themathgeek13/custom-pic-quad/Quad-V3/Eagle/PDF/ControlBoardV3-4L.Brd.pdf

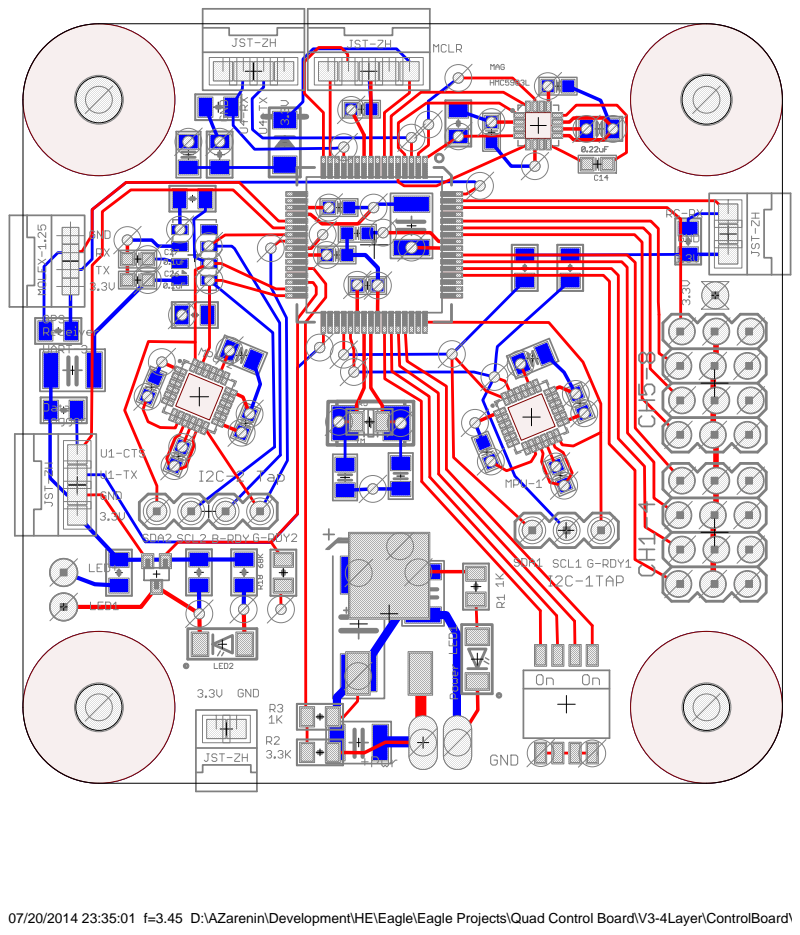
[picture p1: page 1]

07/20/2014 23:35:01 f=3.45 D:\AZarenin\Development\HE\Eagle\Eagle Projects\Quad Control Board\V3-4Layer\ControlBoardV
