themathgeek13/custom-pic-quad/Quad-V3/Eagle/PDF/ControlBoardV3-4L.Description.pdf

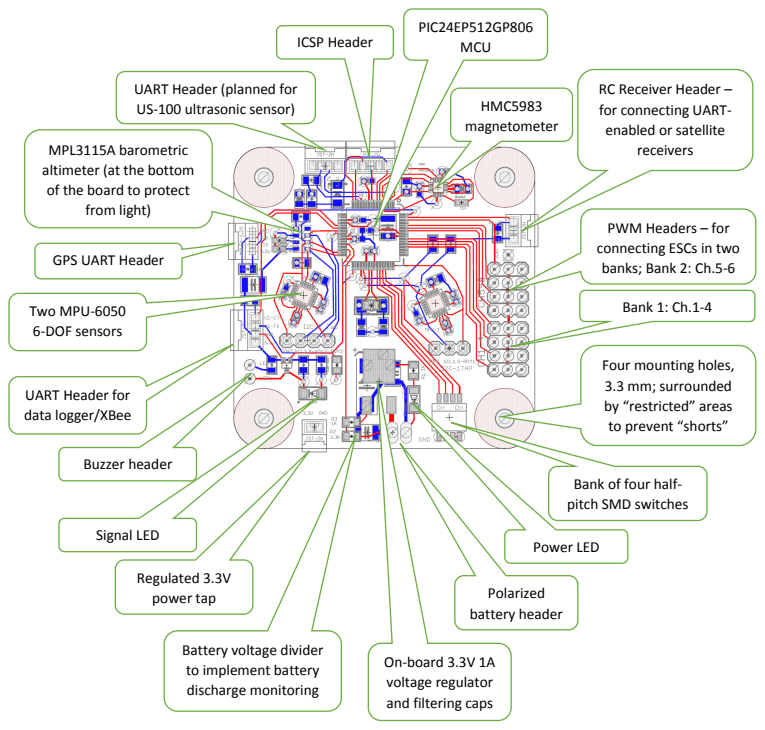
[picture p2: page 1]
ICSP Header; Bank 1: Ch.1-4; Polarized battery header; HMC5983 magnetometer; PIC24EP512GP806 MCU; Buzzer header; Signal LED; Power LED; Regulated 3.3V power tap; Two MPU-6050 6-DOF sensors

UART Header (planned for
US-100 ultrasonic sensor)

RC Receiver Header –
for connecting UART-
enabled or satellite
receivers

MPL3115A barometric
altimeter (at the bottom
of the board to protect
from light)

PWM Headers – for
connecting ESCs in two
banks; Bank 2: Ch.5-6

GPS UART Header

Four mounting holes,
3.3 mm; surrounded
by “restricted” areas
to prevent “shorts”

UART Header for
data logger/XBee

Bank of four half-
pitch SMD switches

Battery voltage divider
to implement battery
discharge monitoring

On-board 3.3V 1A
voltage regulator
and filtering caps
