themathgeek13/custom-pic-quad/Quad-V3/Eagle/PDF/ControlBoardV3-4L.Sch.pdf

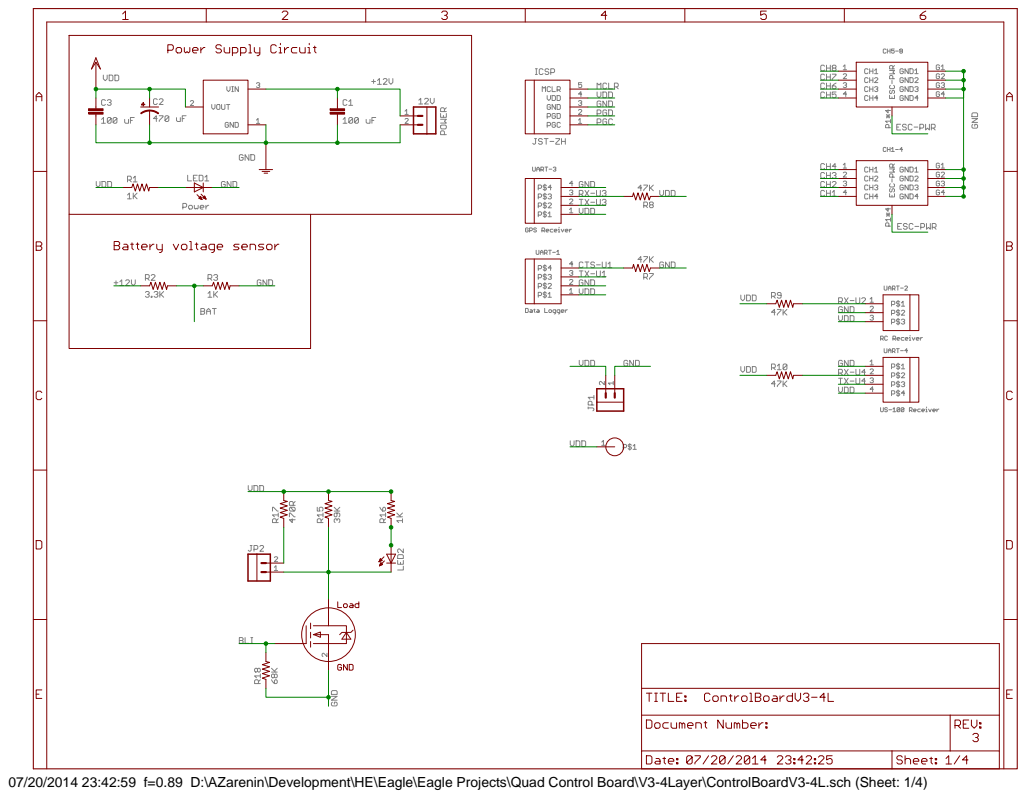
[picture p3: page 1]

07/20/2014 23:42:59 f=0.89 D:\AZarenin\Development\HE\Eagle\Eagle Projects\Quad Control Board\V3-4Layer\ControlBoardV3-4L.sch (Sheet: 1/4)

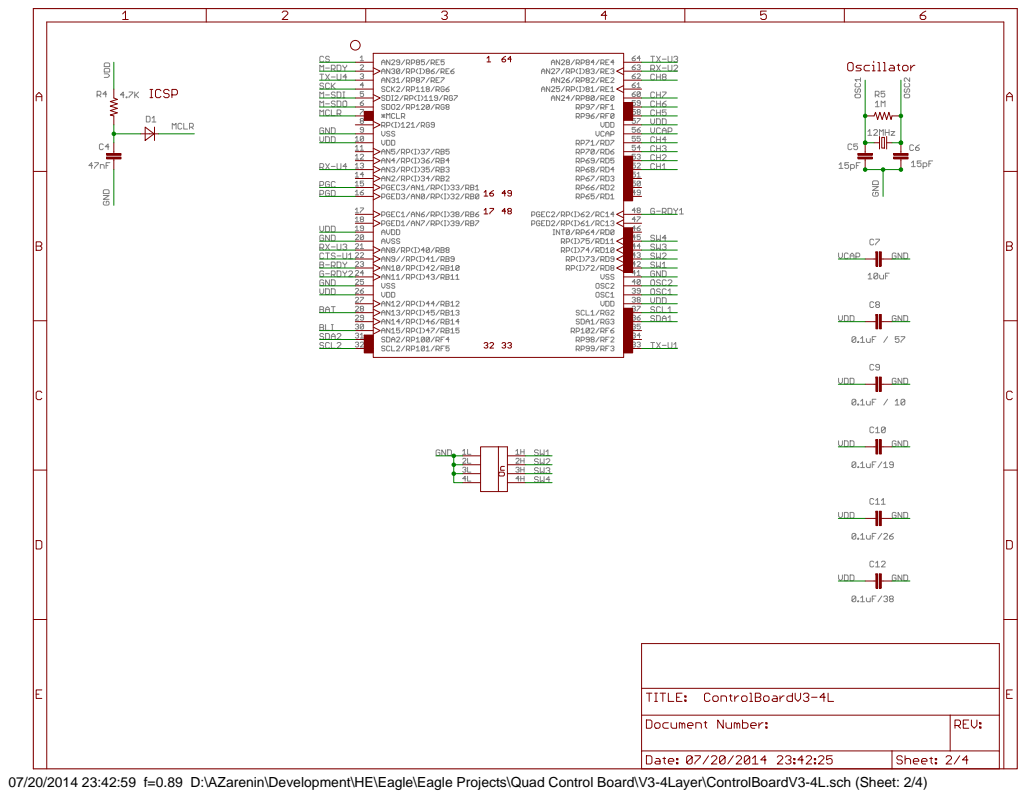
[picture p4: page 2]

07/20/2014 23:42:59 f=0.89 D:\AZarenin\Development\HE\Eagle\Eagle Projects\Quad Control Board\V3-4Layer\ControlBoardV3-4L.sch (Sheet: 2/4)

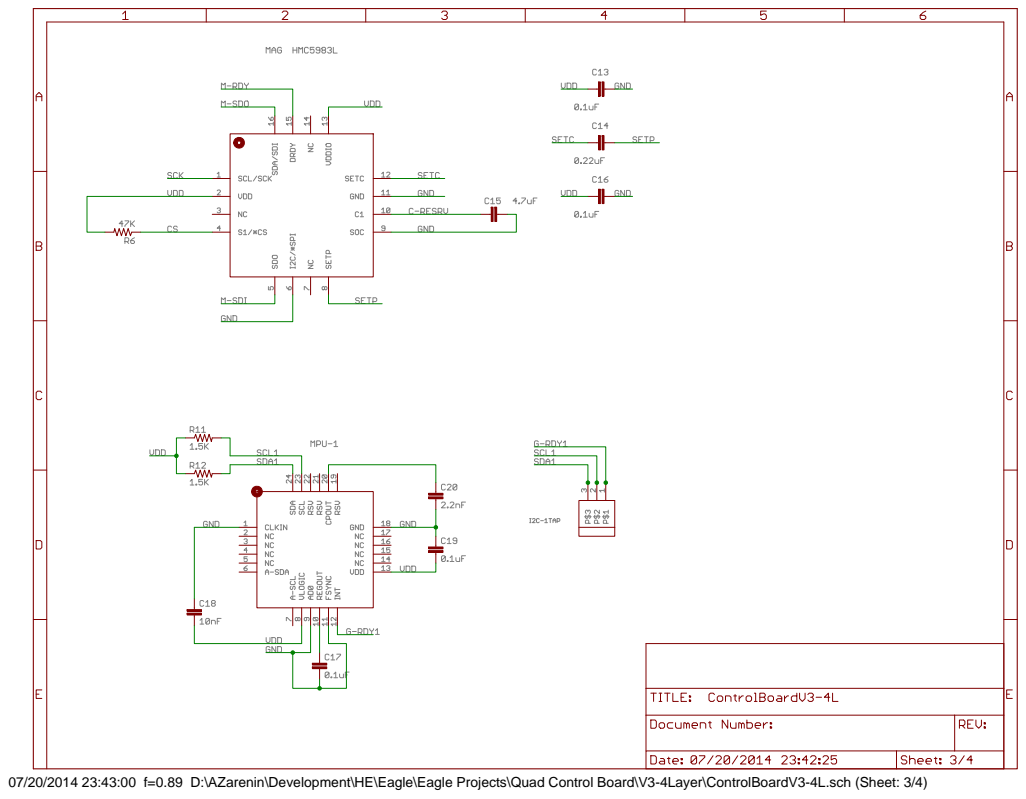
[picture p5: page 3]

07/20/2014 23:43:00 f=0.89 D:\AZarenin\Development\HE\Eagle\Eagle Projects\Quad Control Board\V3-4Layer\ControlBoardV3-4L.sch (Sheet: 3/4)

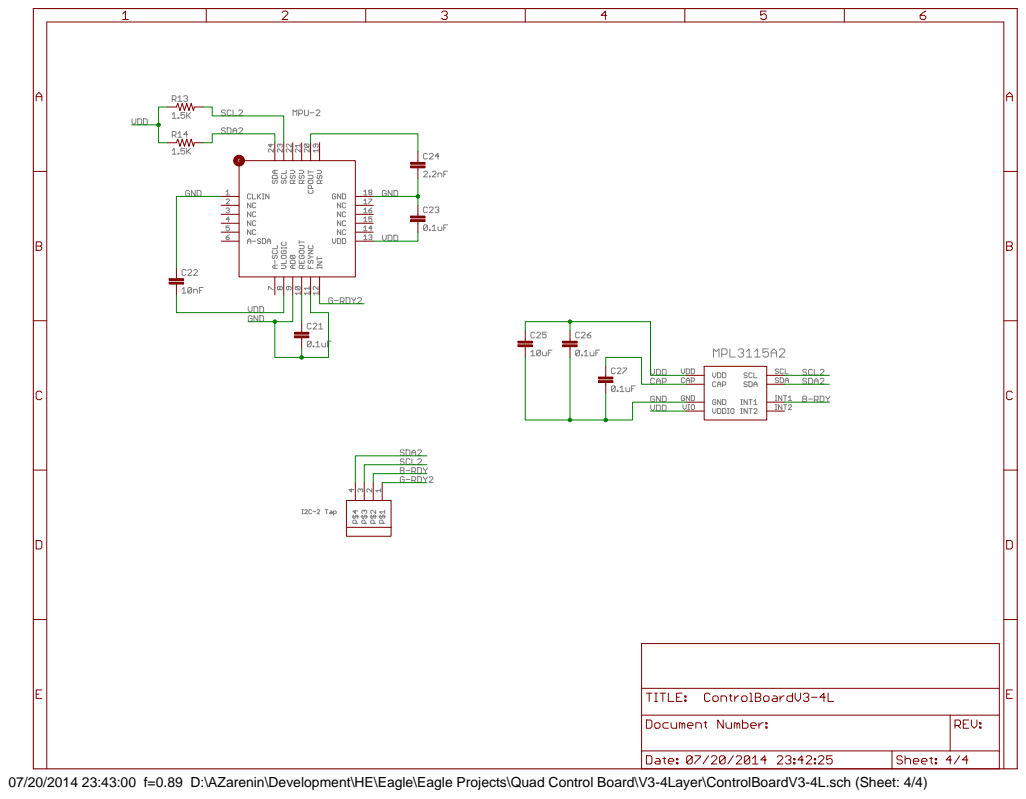
[picture p6: page 4]

07/20/2014 23:43:00 f=0.89 D:\AZarenin\Development\HE\Eagle\Eagle Projects\Quad Control Board\V3-4Layer\ControlBoardV3-4L.sch (Sheet: 4/4)
