themathgeek13/custom-pic-quad/SD-Logger/SD-Logger-V2/Eagle/DataLoggerV2.sch.pdf

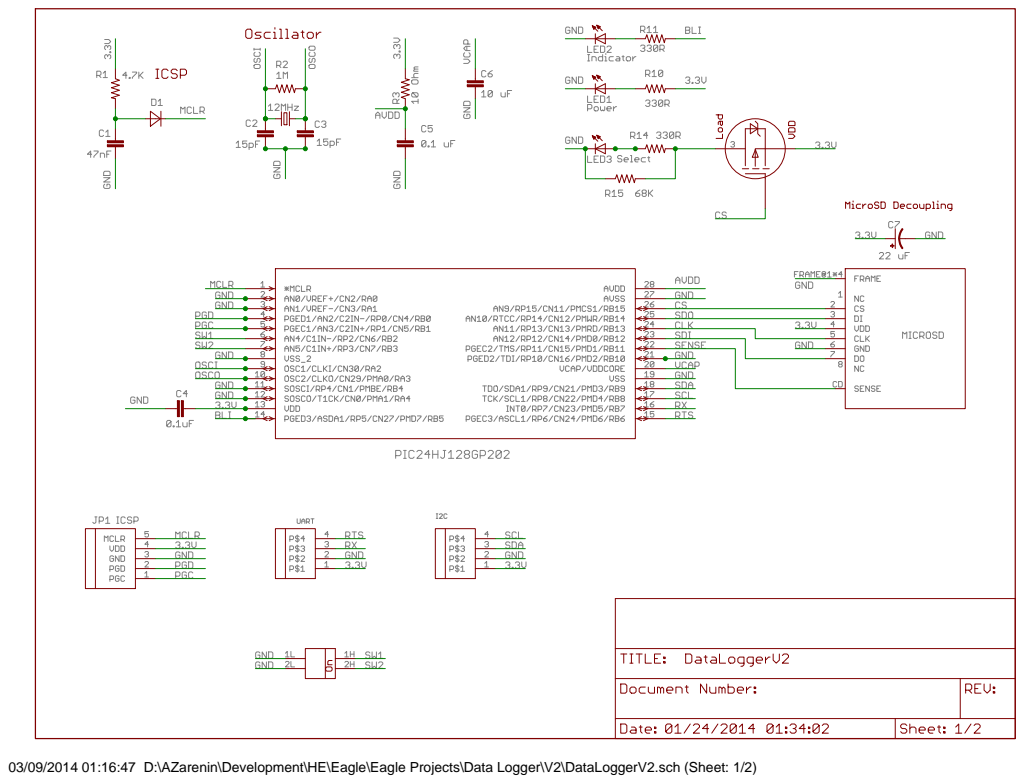
[picture p7: page 1]

03/09/2014 01:16:47 D:\AZarenin\Development\HE\Eagle\Eagle Projects\Data Logger\V2\DataLoggerV2.sch (Sheet: 1/2)
