themathgeek13/custom-pic-quad/Quad-V2/Eagle/Control Board Schematic.pdf

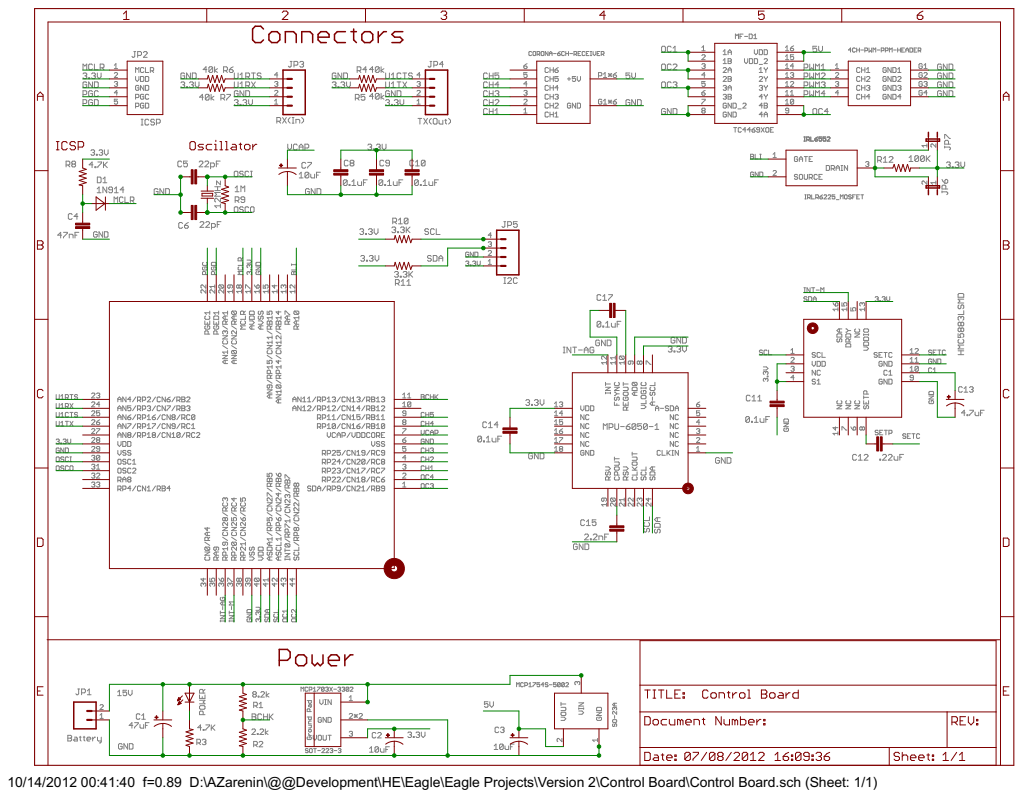
[picture p8: page 1]

10/14/2012 00:41:40 f=0.89 D:\AZarenin\@@Development\HE\Eagle\Eagle Projects\Version 2\Control Board\Control Board.sch (Sheet: 1/1)
