themathgeek13/custom-pic-quad/Quad-V2/Eagle/Control Board.pdf

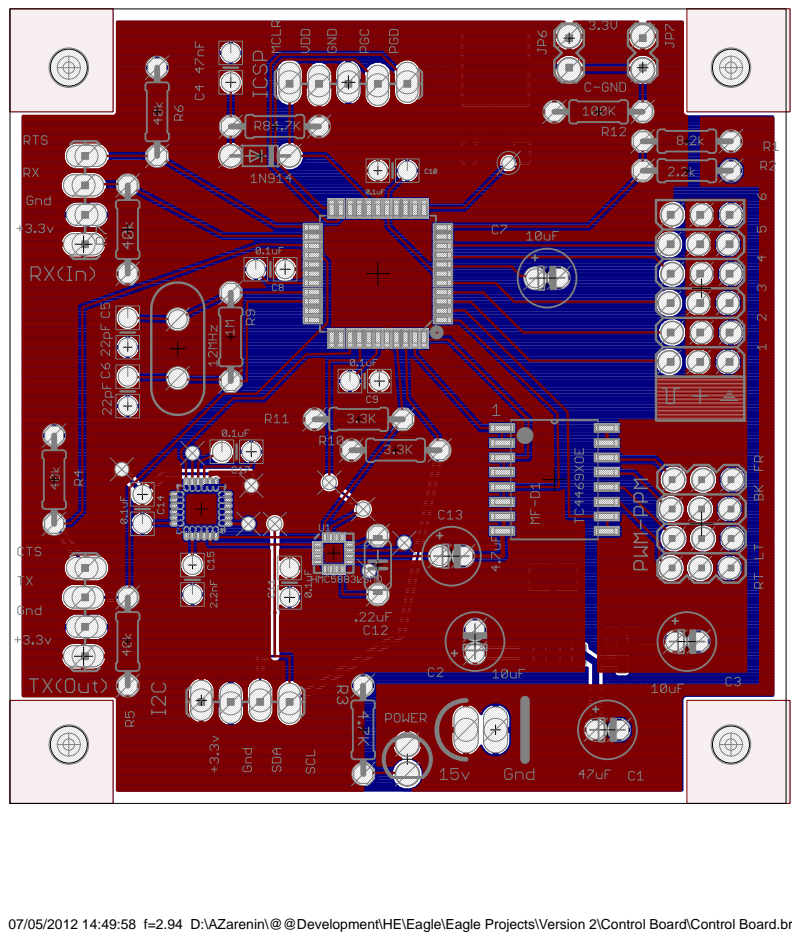
[picture p9: page 1]

07/05/2012 14:49:58 f=2.94 D:\AZarenin\@@Development\HE\Eagle\Eagle Projects\Version 2\Control Board\Control Board.br
