themathgeek13/custom-pic-quad/Quad-V3/Eagle/ControlBoardV3-4L.brd

## EAGLE design Quad-V3/Eagle/ControlBoardV3-4L.brd (2014-07-21)

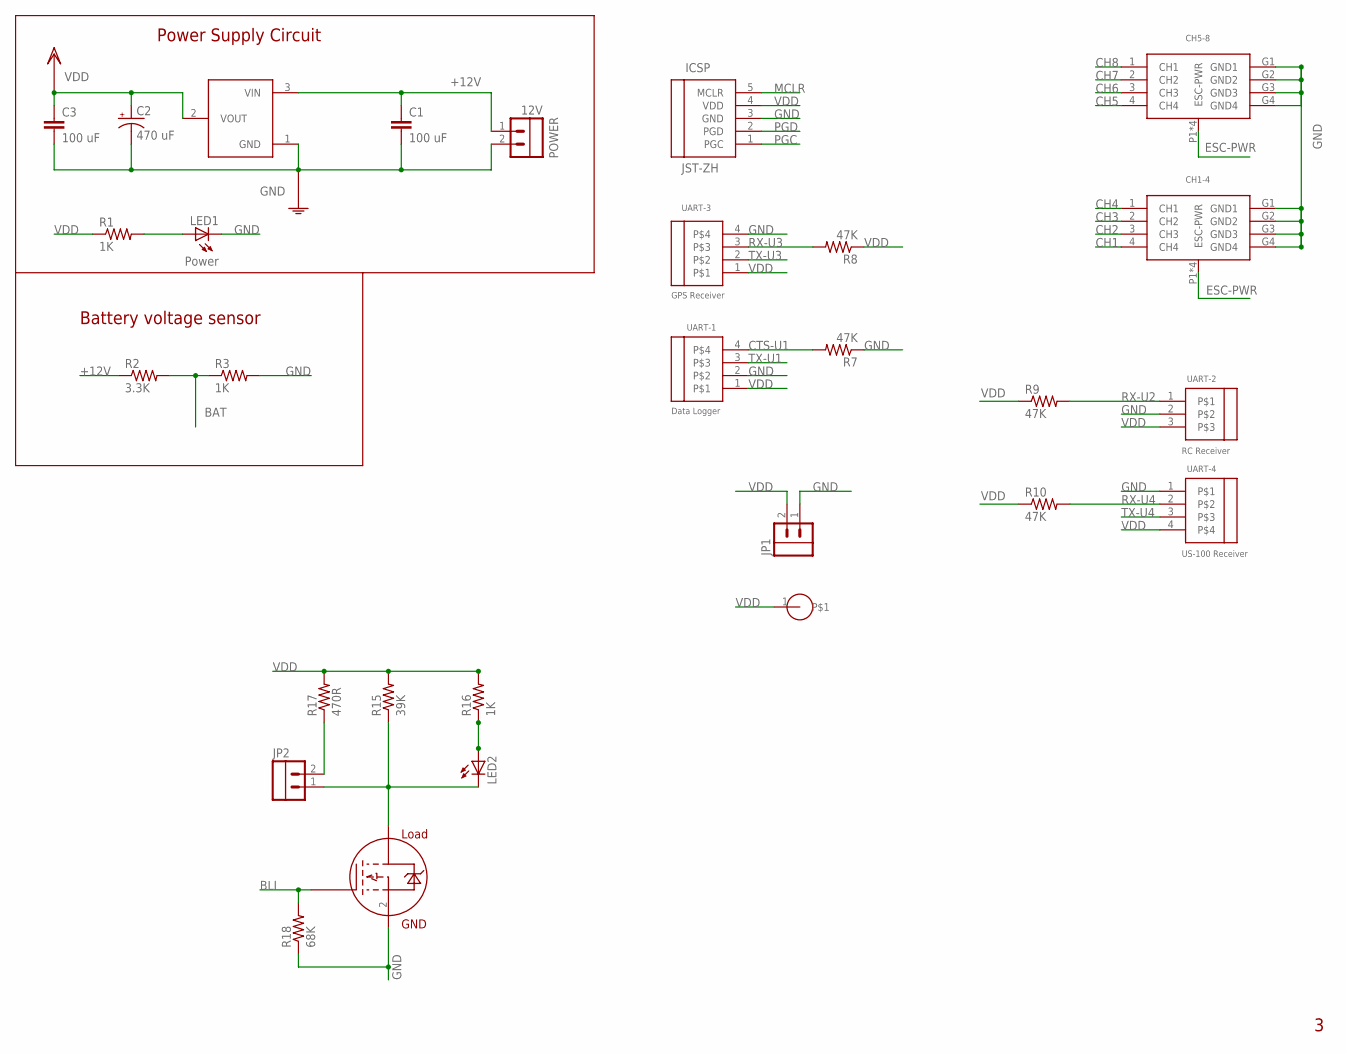
[picture p10: schematic ControlBoardV3-4L.sch, sheet 1]

Parts:
C1, C3: 100 uF; 1210_INCH-HS-CAP
C2: 470 uF; TANT-D-7343
CH1-4, CH5-8: 4CH-PWM-PPM-HEADER; 4CH-PWM-PPM-HEADER-PACKAGE
ICSP: JST-ZH; 1X05-JST-ZH
JP1: HEADER-02_JST_ZH; 1X02-JST-ZH
JP2: HEADER-02_0.1"_NO_SILK; 1X02_100MIL_NO_SILK
LED1: Power; 1206_INCH-HS-LED
LED2: LED_SMD_1206; 1206_INCH-HS-LED
POWER: 12V; 1X02_100MIL_LONGPADS
R1, R3, R16: 1K; 0805_INCH-HS
R2: 3.3K; 0805_INCH-HS
R7, R8, R9, R10: 47K; 0805_INCH-HS
R15: 39K; 0805_INCH-HS
R17: 470R; 0805_INCH-HS
R18: 68K; 0805_INCH-HS
U$2: NCP1117_DPAK; DPAK-ONSEMI
U$5: N-MOSFET_SOT-323; SOT-323
U$6: TAP-01_PRECISE; 1X01_PRECISE
UART-1: Data Logger; 1X04-JST-ZH
UART-2: RC Receiver; 1X03-JST-ZH
UART-3: GPS Receiver; 1X04-MOLEX-PICOBLADE
UART-4: US-100 Receiver; 1X04-JST-ZH

Connections:
+12V: C1.P$1 (1), POWER.1, R2.1, U$2.3 (VIN)
BAT: R2.2, R3.1; also elsewhere on the board
BLI: R18.2, U$5.1 (G); also elsewhere on the board
CH1: CH1-4.4 (CH4); also elsewhere on the board
CH2: CH1-4.3 (CH3); also elsewhere on the board
CH3: CH1-4.2 (CH2); also elsewhere on the board
CH4: CH1-4.1 (CH1); also elsewhere on the board
CH5: CH5-8.4 (CH4); also elsewhere on the board
CH6: CH5-8.3 (CH3); also elsewhere on the board
CH7: CH5-8.2 (CH2); also elsewhere on the board
CH8: CH5-8.1 (CH1); also elsewhere on the board
CTS-U1: R7.2, UART-1.4; also elsewhere on the board
ESC-PWR: CH1-4.P1 (ESC-PWR), CH1-4.P2 (ESC-PWR), CH1-4.P3 (ESC-PWR), CH1-4.P4 (ESC-PWR), CH5-8.P1 (ESC-PWR), CH5-8.P2 (ESC-PWR), CH5-8.P3 (ESC-PWR), CH5-8.P4 (ESC-PWR)
GND: C1.P$2 (2), C2.-, C3.P$2 (2), CH1-4.G1 (GND1), CH1-4.G2 (GND2), CH1-4.G3 (GND3), CH1-4.G4 (GND4), CH5-8.G1 (GND1), CH5-8.G2 (GND2), CH5-8.G3 (GND3), CH5-8.G4 (GND4), ICSP.3 (GND), JP1.1, LED1.C, POWER.2, R3.2, R7.1, R18.1, U$2.1 (GND), U$5.2 (S), UART-1.2, UART-2.2, UART-3.4, UART-4.1; also elsewhere on the board
MCLR: ICSP.5 (MCLR); also elsewhere on the board
unnamed: LED1.A, R1.2
unnamed: JP2.2, R17.1
unnamed: JP2.1, LED2.C, R15.1, U$5.3 (D)
unnamed: LED2.A, R16.1
PGC: ICSP.1 (PGC); also elsewhere on the board
PGD: ICSP.2 (PGD); also elsewhere on the board
RX-U2: R9.2, UART-2.1; also elsewhere on the board
RX-U3: R8.2, UART-3.3; also elsewhere on the board
RX-U4: R10.2, UART-4.2; also elsewhere on the board
TX-U1: UART-1.3; also elsewhere on the board
TX-U3: UART-3.2; also elsewhere on the board
TX-U4: UART-4.3; also elsewhere on the board
VDD: C2.+, C3.P$1 (1), ICSP.4 (VDD), JP1.2, R1.1, R8.1, R9.1, R10.1, R15.2, R16.2, R17.2, U$2.2 (VOUT), U$6.1, UART-1.1, UART-2.3, UART-3.1, UART-4.4; also elsewhere on the board

Notes on the sheet:
Power Supply Circuit
Battery voltage sensor

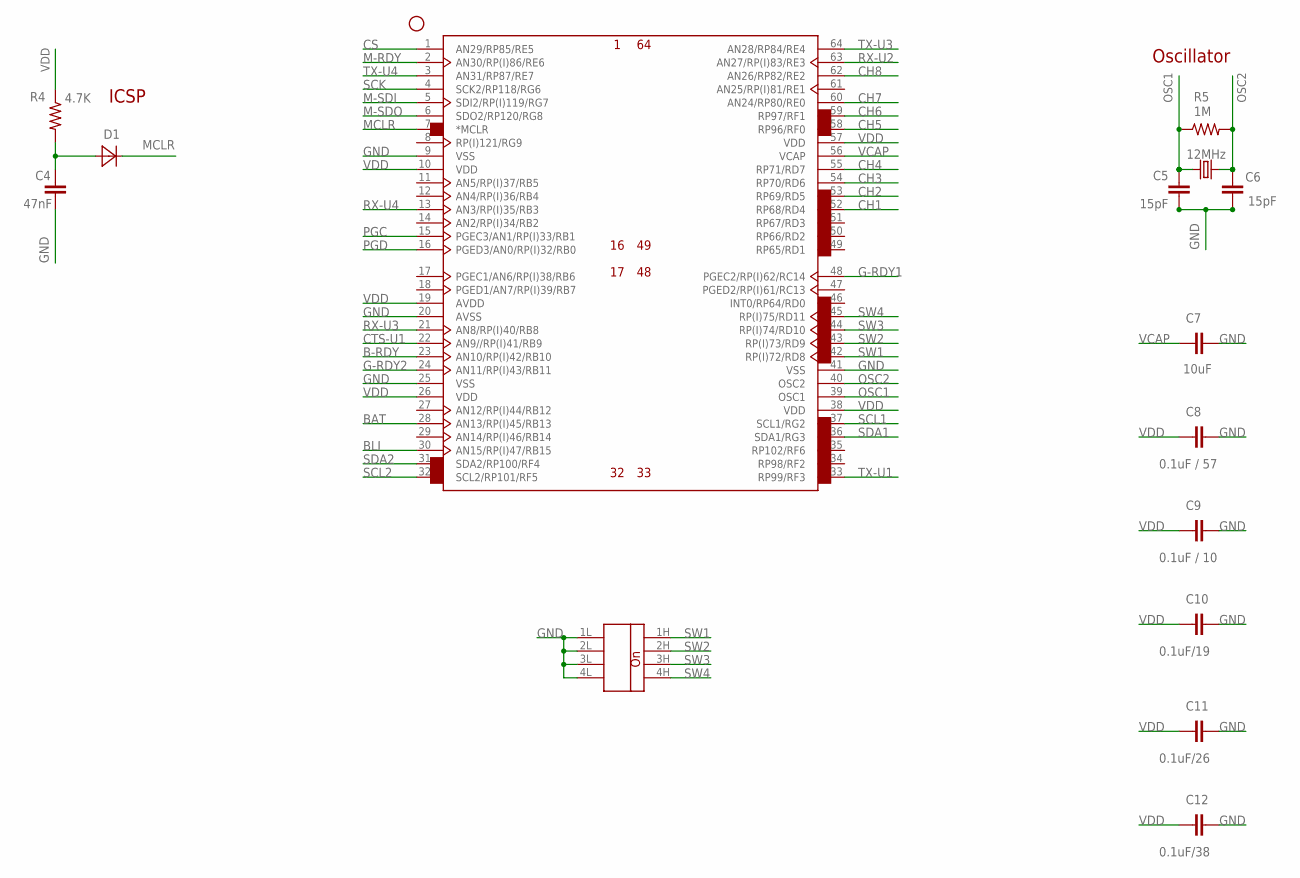
[picture p11: schematic ControlBoardV3-4L.sch, sheet 2]

Parts:
C4: 47nF; 0805_INCH-HS-CAP
C5, C6: 15pF; 0805_INCH-HS-CAP
C7: 10uF; 1210_INCH-HS-CAP
C8: 0.1uF / 57; 0603_INCH-HS-CAP
C9: 0.1uF / 10; 0603_INCH-HS-CAP
C10: 0.1uF/19; 0603_INCH-HS-CAP
C11: 0.1uF/26; 0603_INCH-HS-CAP
C12: 0.1uF/38; 0603_INCH-HS-CAP
D1: DIODE_1206; 1206_INCH-HS-DIODE
Q1: 12MHz; CRYSTAL-SMD-5.0X3.2
R4: 4.7K; 0805_INCH-HS
R5: 1M; 0805_INCH-HS
U$1: PIC24EP512GP806_TQFP64-10X10; TQFP64-10X10X1MM
U$3: SWITCH-4_HALF-PITCH; DIP-4-HP

Connections:
B-RDY: U$1.23 (AN10/RP(I)42/RB10); also elsewhere on the board
BAT: U$1.28 (AN13/RP(I)45/RB13); also elsewhere on the board
BLI: U$1.30 (AN15/RP(I)47/RB15); also elsewhere on the board
CH1: U$1.52 (RP68/RD4); also elsewhere on the board
CH2: U$1.53 (RP69/RD5); also elsewhere on the board
CH3: U$1.54 (RP70/RD6); also elsewhere on the board
CH4: U$1.55 (RP71/RD7); also elsewhere on the board
CH5: U$1.58 (RP96/RF0); also elsewhere on the board
CH6: U$1.59 (RP97/RF1); also elsewhere on the board
CH7: U$1.60 (AN24/RP80/RE0); also elsewhere on the board
CH8: U$1.62 (AN26/RP82/RE2); also elsewhere on the board
CS: U$1.1 (AN29/RP85/RE5); also elsewhere on the board
CTS-U1: U$1.22 (AN9//RP(I)41/RB9); also elsewhere on the board
G-RDY1: U$1.48 (PGEC2/RP(I)62/RC14); also elsewhere on the board
G-RDY2: U$1.24 (AN11/RP(I)43/RB11); also elsewhere on the board
GND: C4.2, C5.1, C6.1, C7.P$2 (2), C8.2, C9.2, C10.2, C11.2, C12.2, U$1.9 (VSS), U$1.20 (AVSS), U$1.25 (VSS), U$1.41 (VSS), U$3.1L, U$3.2L, U$3.3L, U$3.4L; also elsewhere on the board
M-RDY: U$1.2 (AN30/RP(I)86/RE6); also elsewhere on the board
M-SDI: U$1.5 (SDI2/RP(I)119/RG7); also elsewhere on the board
M-SDO: U$1.6 (SDO2/RP120/RG8); also elsewhere on the board
MCLR: D1.C, U$1.7 (*MCLR); also elsewhere on the board
unnamed: C4.1, D1.A, R4.2
OSC1: C5.2, Q1.P$2 (2), R5.1, U$1.39 (OSC1)
OSC2: C6.2, Q1.P$1 (1), R5.2, U$1.40 (OSC2)
PGC: U$1.15 (PGEC3/AN1/RP(I)33/RB1); also elsewhere on the board
PGD: U$1.16 (PGED3/AN0/RP(I)32/RB0); also elsewhere on the board
RX-U2: U$1.63 (AN27/RP(I)83/RE3); also elsewhere on the board
RX-U3: U$1.21 (AN8/RP(I)40/RB8); also elsewhere on the board
RX-U4: U$1.13 (AN3/RP(I)35/RB3); also elsewhere on the board
SCK: U$1.4 (SCK2/RP118/RG6); also elsewhere on the board
SCL1: U$1.37 (SCL1/RG2); also elsewhere on the board
SCL2: U$1.32 (SCL2/RP101/RF5); also elsewhere on the board
SDA1: U$1.36 (SDA1/RG3); also elsewhere on the board
SDA2: U$1.31 (SDA2/RP100/RF4); also elsewhere on the board
SW1: U$1.42 (RP(I)72/RD8), U$3.1H
SW2: U$1.43 (RP(I)73/RD9), U$3.2H
SW3: U$1.44 (RP(I)74/RD10), U$3.3H
SW4: U$1.45 (RP(I)75/RD11), U$3.4H
TX-U1: U$1.33 (RP99/RF3); also elsewhere on the board
TX-U3: U$1.64 (AN28/RP84/RE4); also elsewhere on the board
TX-U4: U$1.3 (AN31/RP87/RE7); also elsewhere on the board
VCAP: C7.P$1 (1), U$1.56 (VCAP)
VDD: C8.1, C9.1, C10.1, C11.1, C12.1, R4.1, U$1.10 (VDD), U$1.19 (AVDD), U$1.26 (VDD), U$1.38 (VDD), U$1.57 (VDD); also elsewhere on the board

Notes on the sheet:
ICSP
Oscillator

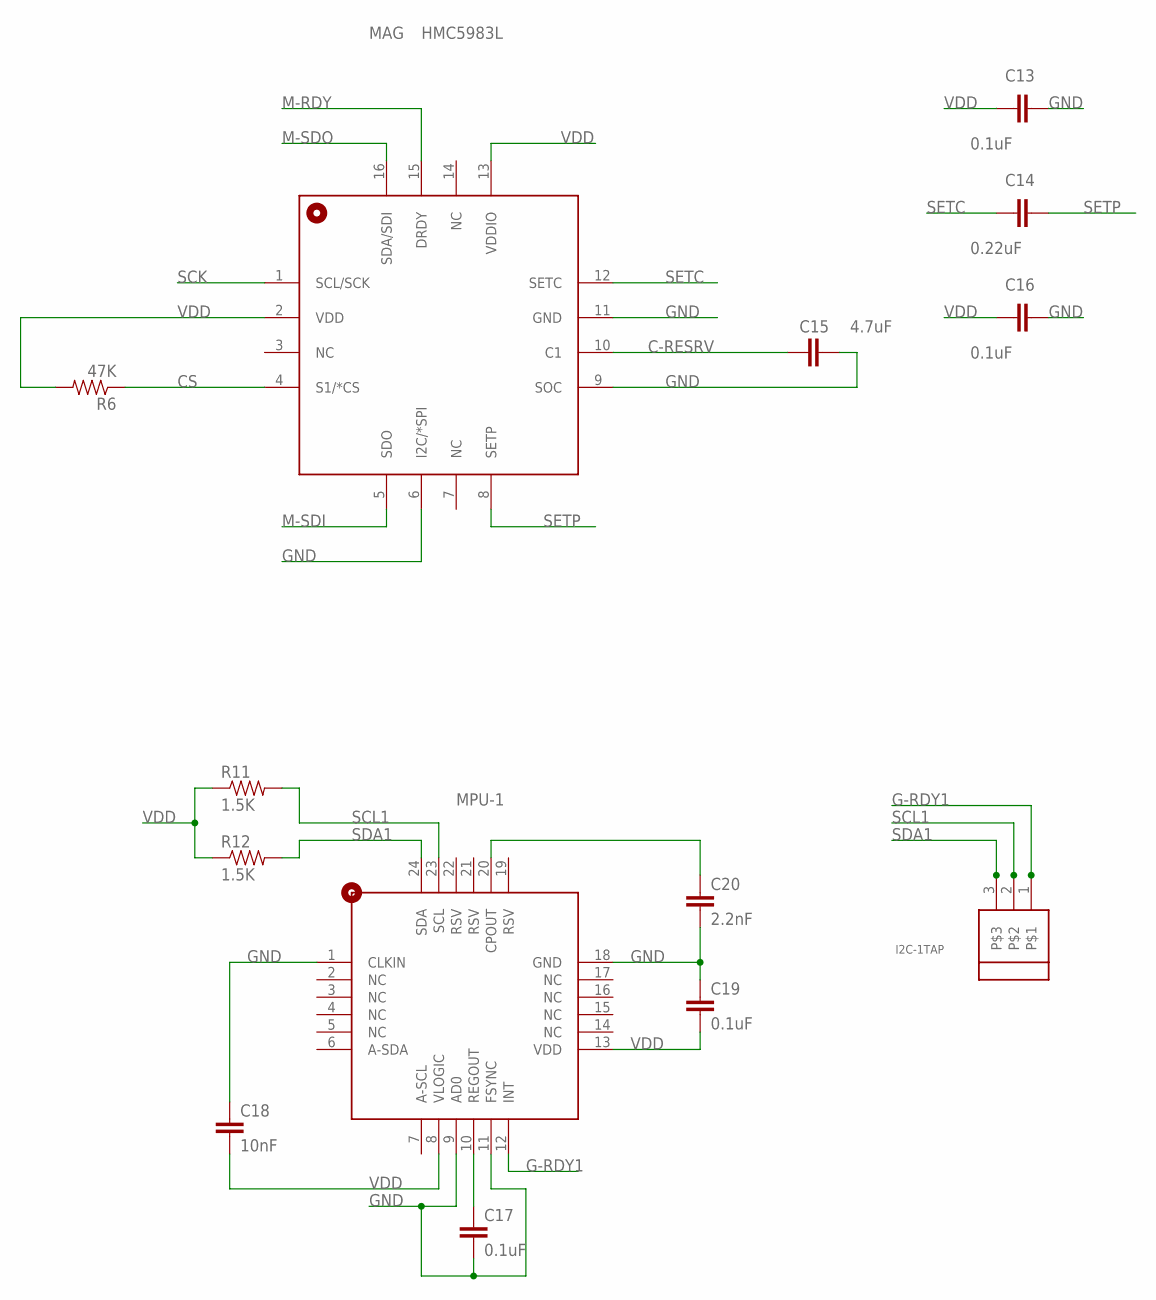
[picture p12: schematic ControlBoardV3-4L.sch, sheet 3]

Parts:
C13, C16, C17, C19: 0.1uF; 0603_INCH-HS-CAP
C14: 0.22uF; 0603_INCH-HS-CAP
C15: 4.7uF; 0805_INCH-HS-CAP
C18: 10nF; 0603_INCH-HS-CAP
C20: 2.2nF; 0805_INCH-HS-CAP
I2C-1TAP: HEADER-03_MACHINED; 1X03-100MIL-MACHINED
MAG: HMC5983L; HMC5X83L-16LPCC
MPU-1: MPU-6050-1; MPU-6050_QFN-24-4MM2_AZ
R6: 47K; 0805_INCH-HS
R11, R12: 1.5K; 0805_INCH-HS

Connections:
C-RESRV: C15.1, MAG.10 (C1)
CS: MAG.4 (S1/*CS), R6.1; also elsewhere on the board
G-RDY1: I2C-1TAP.1, MPU-1.12 (INT); also elsewhere on the board
GND: C13.2, C15.2, C16.2, C17.2, C18.1, C19.1, C20.2, MAG.6 (I2C/*SPI), MAG.9 (SOC), MAG.11 (GND), MPU-1.1 (CLKIN), MPU-1.9 (AD0), MPU-1.11 (FSYNC), MPU-1.18 (GND); also elsewhere on the board
M-RDY: MAG.15 (DRDY); also elsewhere on the board
M-SDI: MAG.5 (SDO); also elsewhere on the board
M-SDO: MAG.16 (SDA/SDI); also elsewhere on the board
unnamed: C17.1, MPU-1.10 (REGOUT)
unnamed: C20.1, MPU-1.20 (CPOUT)
SCK: MAG.1 (SCL/SCK); also elsewhere on the board
SCL1: I2C-1TAP.2, MPU-1.23 (SCL), R11.2; also elsewhere on the board
SDA1: I2C-1TAP.3, MPU-1.24 (SDA), R12.2; also elsewhere on the board
SETC: C14.1, MAG.12 (SETC)
SETP: C14.2, MAG.8 (SETP)
VDD: C13.1, C16.1, C18.2, C19.2, MAG.2 (VDD), MAG.13 (VDDIO), MPU-1.8 (VLOGIC), MPU-1.13 (VDD), R6.2, R11.1, R12.1; also elsewhere on the board

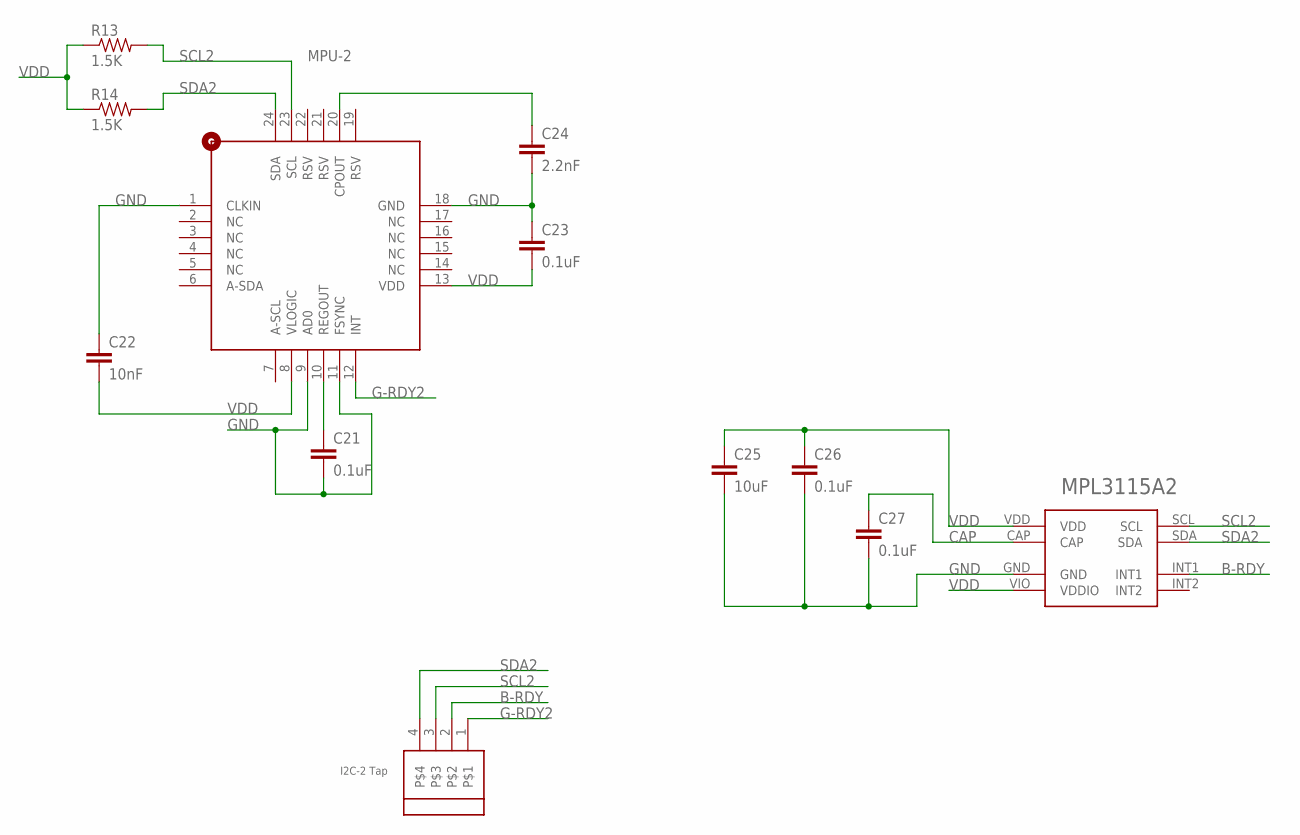
[picture p13: schematic ControlBoardV3-4L.sch, sheet 4]

Parts:
C21, C23, C26, C27: 0.1uF; 0603_INCH-HS-CAP
C22: 10nF; 0603_INCH-HS-CAP
C24: 2.2nF; 0805_INCH-HS-CAP
C25: 10uF; 1210_INCH-HS-CAP
MPL3115A2: MPL-3115A2
MPU-2: MPU-6050-1; MPU-6050_QFN-24-4MM2_AZ
R13, R14: 1.5K; 0805_INCH-HS
U$4: I2C-2 Tap; 1X04-100MIL-MACHINED

Connections:
B-RDY: MPL3115A2.INT1, U$4.2; also elsewhere on the board
CAP: C27.1, MPL3115A2.CAP
G-RDY2: MPU-2.12 (INT), U$4.1; also elsewhere on the board
GND: C21.2, C22.1, C23.1, C24.2, C25.P$2 (2), C26.2, C27.2, MPL3115A2.GND, MPU-2.1 (CLKIN), MPU-2.9 (AD0), MPU-2.11 (FSYNC), MPU-2.18 (GND); also elsewhere on the board
unnamed: C21.1, MPU-2.10 (REGOUT)
unnamed: C24.1, MPU-2.20 (CPOUT)
SCL2: MPL3115A2.SCL, MPU-2.23 (SCL), R13.2, U$4.3; also elsewhere on the board
SDA2: MPL3115A2.SDA, MPU-2.24 (SDA), R14.2, U$4.4; also elsewhere on the board
VDD: C22.2, C23.2, C25.P$1 (1), C26.1, MPL3115A2.VDD, MPL3115A2.VIO (VDDIO), MPU-2.8 (VLOGIC), MPU-2.13 (VDD), R13.1, R14.1; also elsewhere on the board

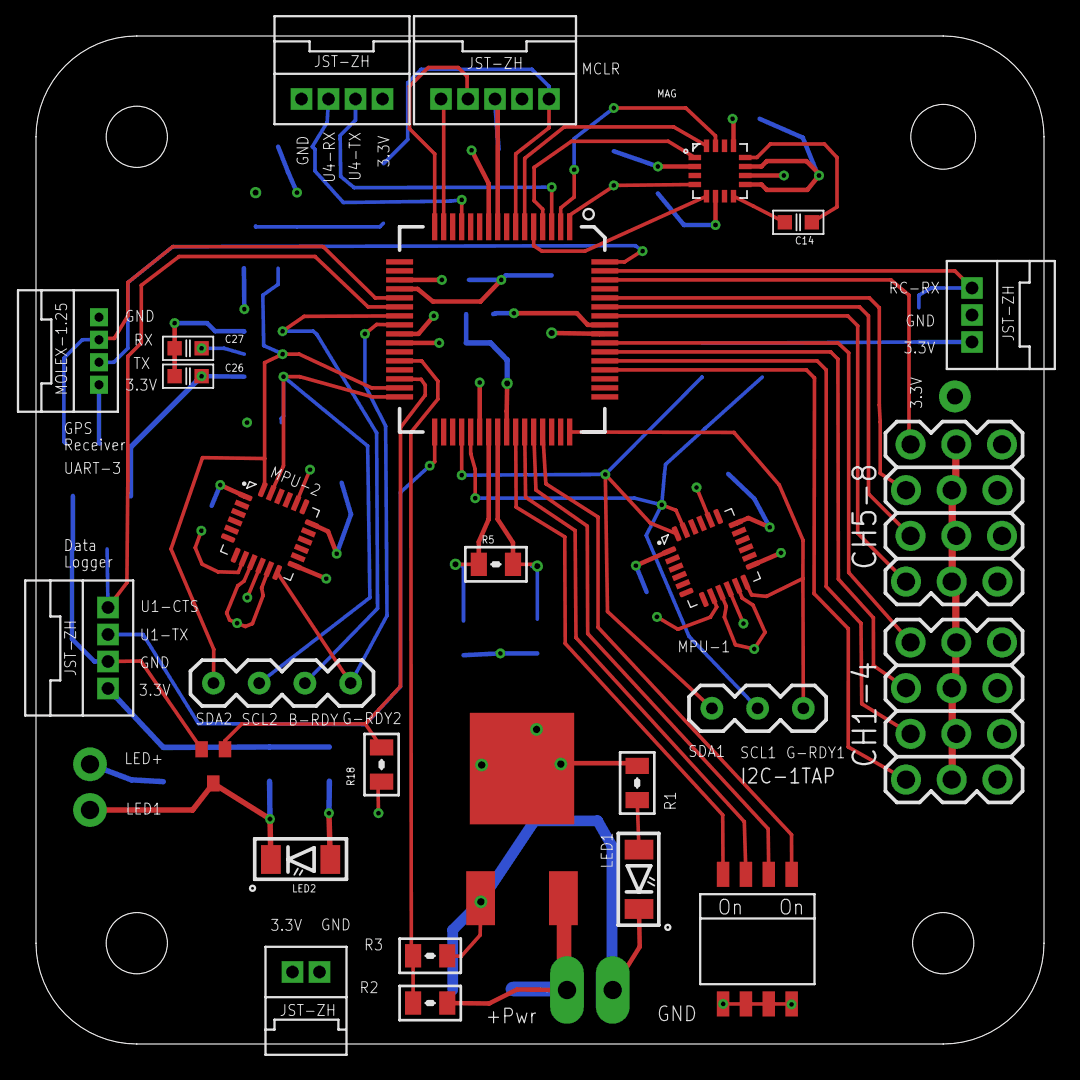
[picture p14: board ControlBoardV3-4L.brd from above]

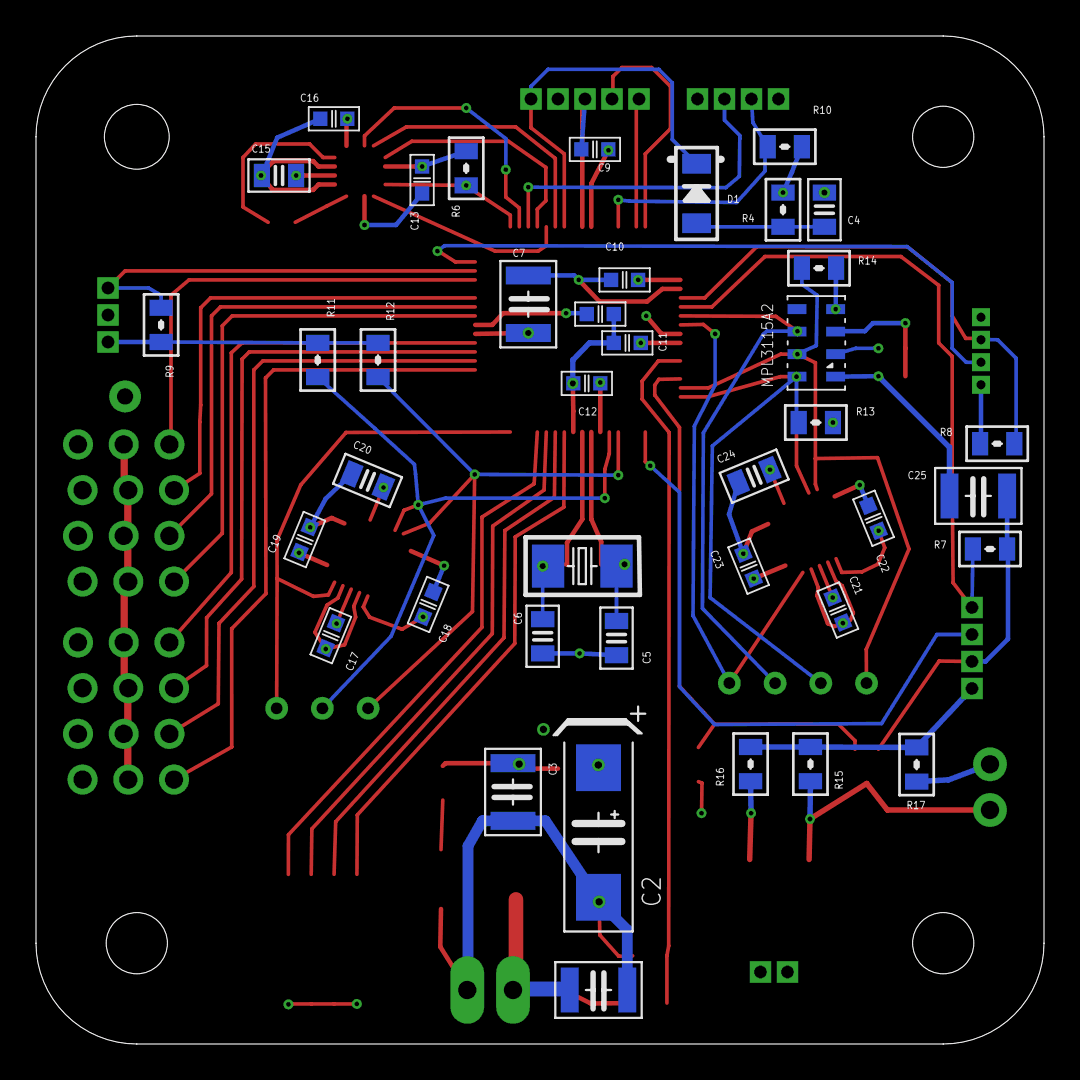
[picture p15: board ControlBoardV3-4L.brd from below]

Board: 4 copper layers, 56.0 x 56.0 mm, 70 parts (40 on the bottom side), 56 nets.
