themathgeek13/custom-pic-quad/Quad-V2/Eagle/Control Board.brd

## EAGLE design Quad-V2/Eagle/Control Board.brd (2013-11-05, an earlier design)

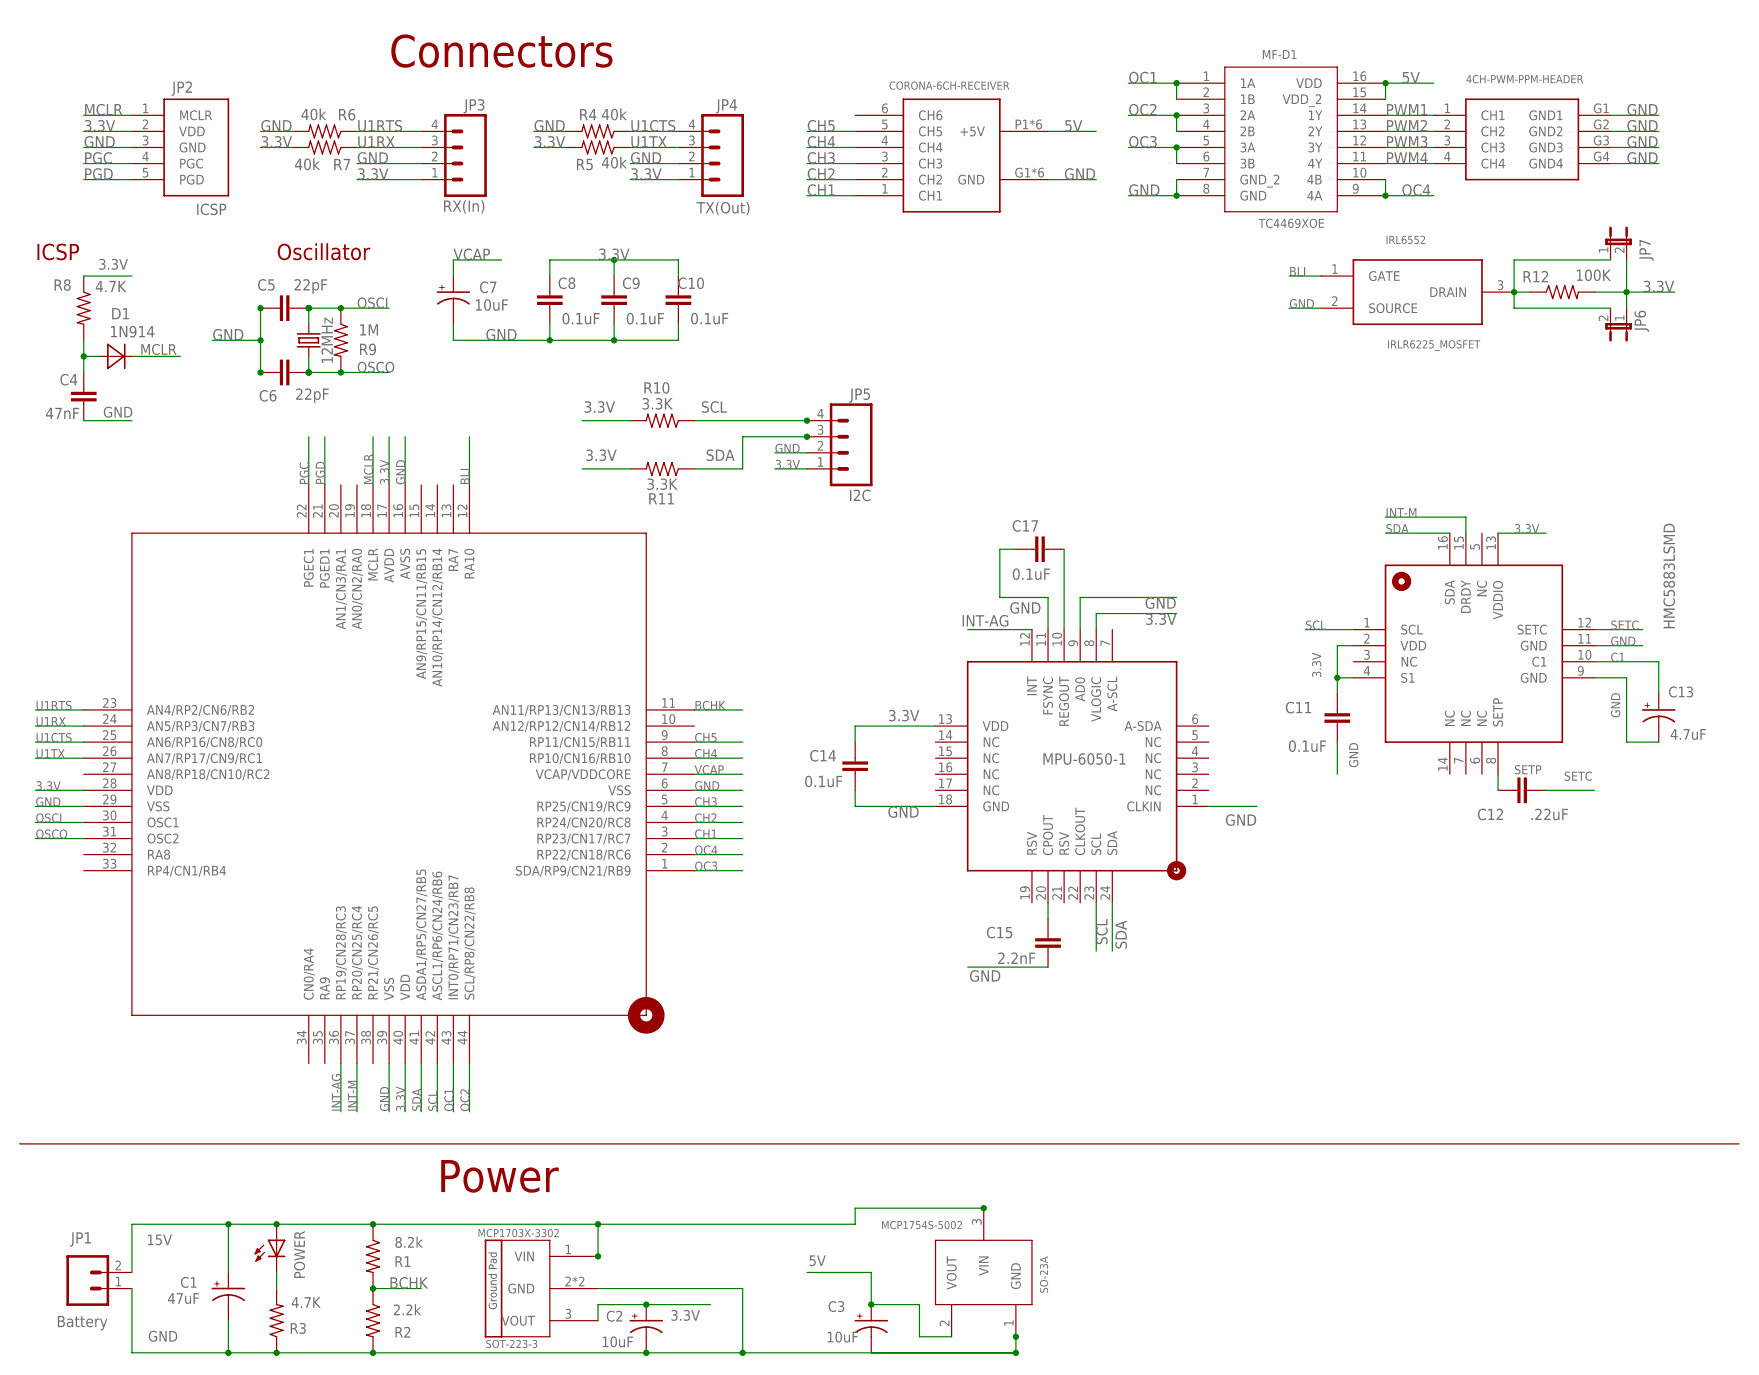
[picture p16: schematic Control Board.sch]

Parts:
C1: 47uF; E2-5
C2, C3, C7: 10uF; E2-5
C4: 47nF; CAP-SMALL-2MM-SMALLPAD
C5, C6: 22pF; CAP-SMALL-2MM-SMALLPAD
C8, C9, C10, C11, C14, C17: 0.1uF; CAP-SMALL-2MM-SMALLPAD
C12: .22uF; C050-024X044
C13: 4.7uF; E2-5
C15: 2.2nF; CAP-SMALL-2MM-SMALLPAD
CR1: CORONA-6CH-RECEIVER; CORONA-6CH-RECEIVER-FOOTPRINT
D1: 1N914; DO34-5
IRL6552: IRLR6225_MOSFET; TO252
JP1: Battery; 1X02_LONGPADS
JP2: ICSP; ICSP_LOCK_LONGPADS
JP3: RX(In); 1X04_LOCK_LONGPADS
JP4: TX(Out); 1X04_LOCK_LONGPADS
JP5: I2C; 1X04_LOCK_LONGPADS
JP6, JP7: JUMPER-2PTH_LOCK; 1X02_LOCK
MCP1703X-3302: SOT-223-3; SOT-223_3MC
MCP1754S-5002: SO-23A; SOT-23A_MC
MF-D1: TC4469XOE; SOIC16_W_MC
POWER: LED3MM
PWM-PPM: 4CH-PWM-PPM-HEADER; 4CH-PWM-PPM-HEADER-PACKAGE
Q1: 12MHz; HC49US
R1: 8.2k; 0204/7
R2: 2.2k; 0204/7
R3, R8: 4.7K; 0204/7
R4, R5, R6, R7: 40k; 0204/7
R9: 1M; 0204/7
R10, R11: 3.3K; 0204/7
R12: 100K; 0204/7
U1: HMC5883LSMD; HMC5883L-16LPCC
U$1: MPU-6050-1; MPU-6050_QFN-24-4MM2_AZ
U$3: PIC24HJ128GP204_AZ; TQFP44_10X10MC

Connections:
3.3V: C2.+, C8.1, C9.1, C10.1, C11.2, C14.1, JP2.2 (VDD), JP3.1, JP4.1, JP5.1, JP6.1, JP7.2, MCP1703X-3302.3 (VOUT), R5.2, R7.2, R8.1, R10.2, R11.2, R12.2, U1.2 (VDD), U1.4 (S1), U1.13 (VDDIO), U$1.8 (VLOGIC), U$1.13 (VDD), U$3.17 (AVDD), U$3.28 (VDD), U$3.40 (VDD)
5V: C3.+, CR1.P1 (+5V), CR1.P2 (+5V), CR1.P3 (+5V), CR1.P4 (+5V), CR1.P5 (+5V), CR1.P6 (+5V), MCP1754S-5002.2 (VOUT), MF-D1.15 (VDD_2), MF-D1.16 (VDD)
15V: C1.+, JP1.2, MCP1703X-3302.1 (VIN), MCP1754S-5002.3 (VIN), POWER.A, R1.1
BCHK: R1.2, R2.1, U$3.11 (AN11/RP13/CN13/RB13)
BLI: IRL6552.1 (GATE), U$3.12 (RA10)
C1: C13.+, U1.10 (C1)
CH1: CR1.1 (CH1), U$3.3 (RP23/CN17/RC7)
CH2: CR1.2 (CH2), U$3.4 (RP24/CN20/RC8)
CH3: CR1.3 (CH3), U$3.5 (RP25/CN19/RC9)
CH4: CR1.4 (CH4), U$3.8 (RP10/CN16/RB10)
CH5: CR1.5 (CH5), U$3.9 (RP11/CN15/RB11)
GND: C1.-, C2.-, C3.-, C4.2, C5.1, C6.1, C7.-, C8.2, C9.2, C10.2, C11.1, C13.-, C14.2, C15.2, C17.1, CR1.G1 (GND), CR1.G2 (GND), CR1.G3 (GND), CR1.G4 (GND), CR1.G5 (GND), CR1.G6 (GND), IRL6552.2 (SOURCE), JP1.1, JP2.3 (GND), JP3.2, JP4.2, JP5.2, MCP1703X-3302.2 (GND), MCP1703X-3302.4 (GND), MCP1754S-5002.1 (GND), MF-D1.7 (GND_2), MF-D1.8 (GND), PWM-PPM.G1 (GND1), PWM-PPM.G2 (GND2), PWM-PPM.G3 (GND3), PWM-PPM.G4 (GND4), R2.2, R3.1, R4.2, R6.2, U1.9 (GND), U1.11 (GND), U$1.1 (CLKIN), U$1.9 (AD0), U$1.11 (FSYNC), U$1.18 (GND), U$3.6 (VSS), U$3.16 (AVSS), U$3.29 (VSS), U$3.39 (VSS)
INT-AG: U$1.12 (INT), U$3.36 (RP19/CN28/RC3)
INT-M: U1.15 (DRDY), U$3.37 (RP20/CN25/RC4)
MCLR: D1.C, JP2.1 (MCLR), U$3.18 (MCLR)
unnamed: C4.1, D1.A, R8.2
unnamed: IRL6552.3 (DRAIN), JP6.2, JP7.1, R12.1
unnamed: C17.2, U$1.10 (REGOUT)
unnamed: POWER.K (C), R3.2
unnamed: C15.1, U$1.20 (CPOUT)
OC1: MF-D1.1 (1A), MF-D1.2 (1B), U$3.43 (INT0/RP71/CN23/RB7)
OC2: MF-D1.3 (2A), MF-D1.4 (2B), U$3.44 (SCL/RP8/CN22/RB8)
OC3: MF-D1.5 (3A), MF-D1.6 (3B), U$3.1 (SDA/RP9/CN21/RB9)
OC4: MF-D1.9 (4A), MF-D1.10 (4B), U$3.2 (RP22/CN18/RC6)
OSCI: C5.2, Q1.2, R9.1, U$3.30 (OSC1)
OSCO: C6.2, Q1.1, R9.2, U$3.31 (OSC2)
PGC: JP2.4 (PGC), U$3.22 (PGEC1)
PGD: JP2.5 (PGD), U$3.21 (PGED1)
PWM1: MF-D1.14 (1Y), PWM-PPM.1 (CH1)
PWM2: MF-D1.13 (2Y), PWM-PPM.2 (CH2)
PWM3: MF-D1.12 (3Y), PWM-PPM.3 (CH3)
PWM4: MF-D1.11 (4Y), PWM-PPM.4 (CH4)
SCL: JP5.4, R10.1, U1.1 (SCL), U$1.23 (SCL), U$3.42 (ASCL1/RP6/CN24/RB6)
SDA: JP5.3, R11.1, U1.16 (SDA), U$1.24 (SDA), U$3.41 (ASDA1/RP5/CN27/RB5)
SETC: C12.2, U1.12 (SETC)
SETP: C12.1, U1.8 (SETP)
U1CTS: JP4.4, R4.1, U$3.25 (AN6/RP16/CN8/RC0)
U1RTS: JP3.4, R6.1, U$3.23 (AN4/RP2/CN6/RB2)
U1RX: JP3.3, R7.1, U$3.24 (AN5/RP3/CN7/RB3)
U1TX: JP4.3, R5.1, U$3.26 (AN7/RP17/CN9/RC1)
VCAP: C7.+, U$3.7 (VCAP/VDDCORE)

Notes on the sheet:
Power
Connectors
ICSP
Oscillator

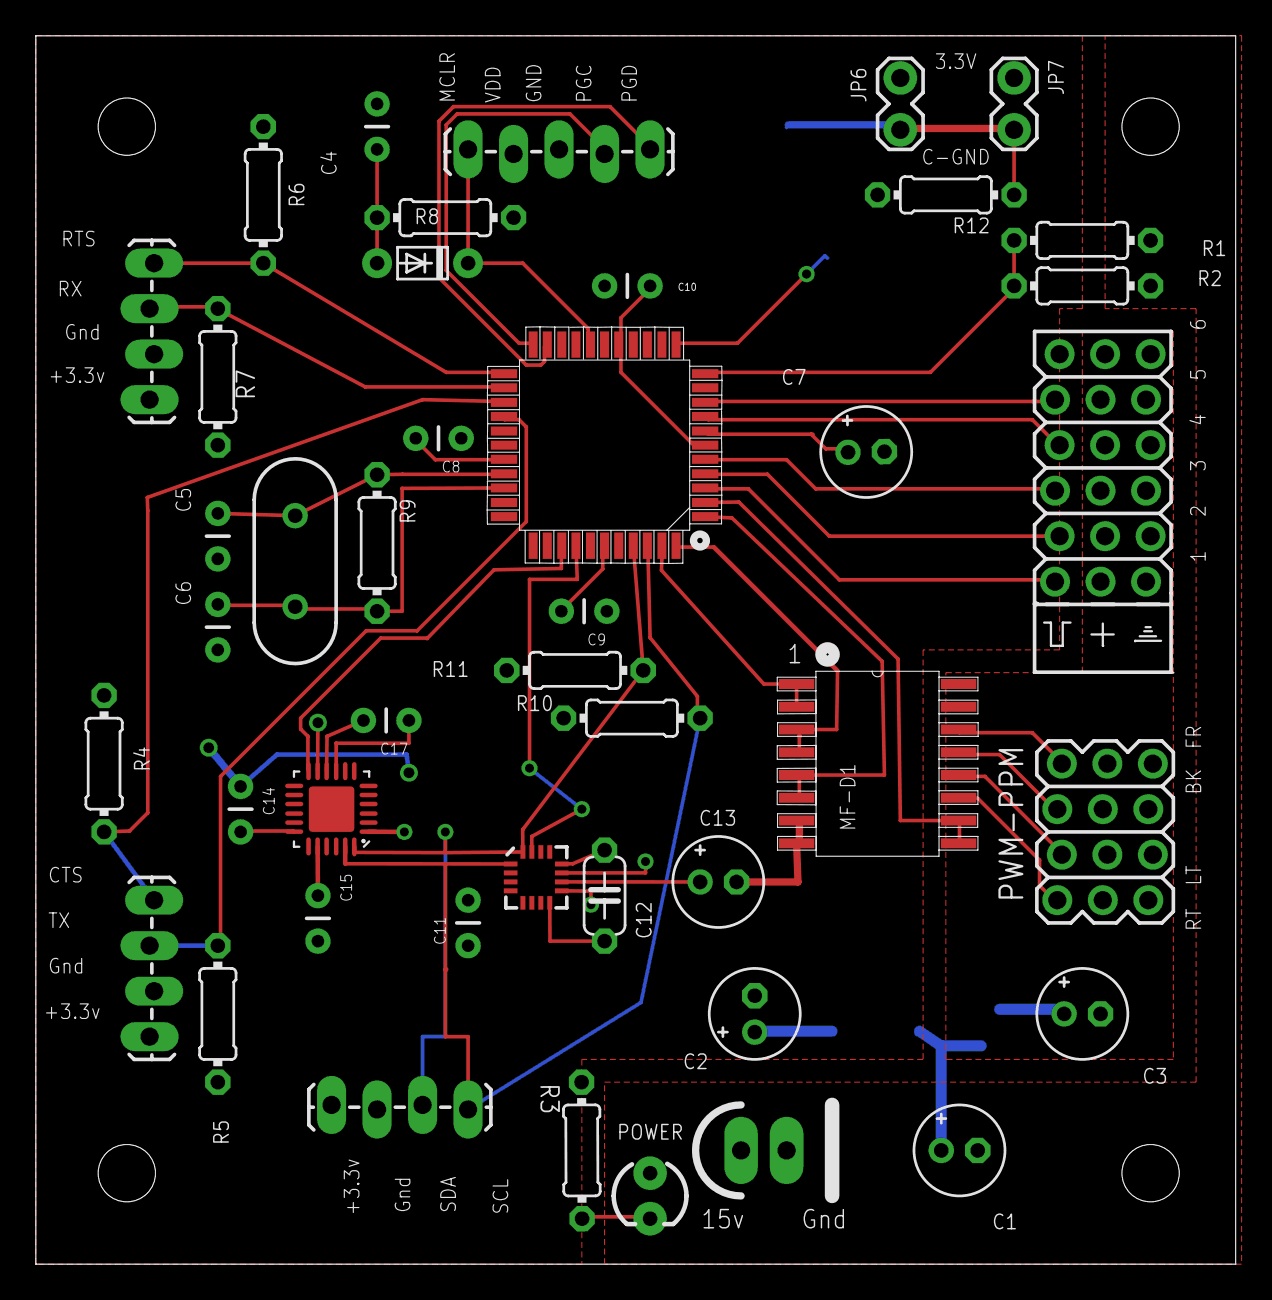
[picture p17: board Control Board.brd from above]

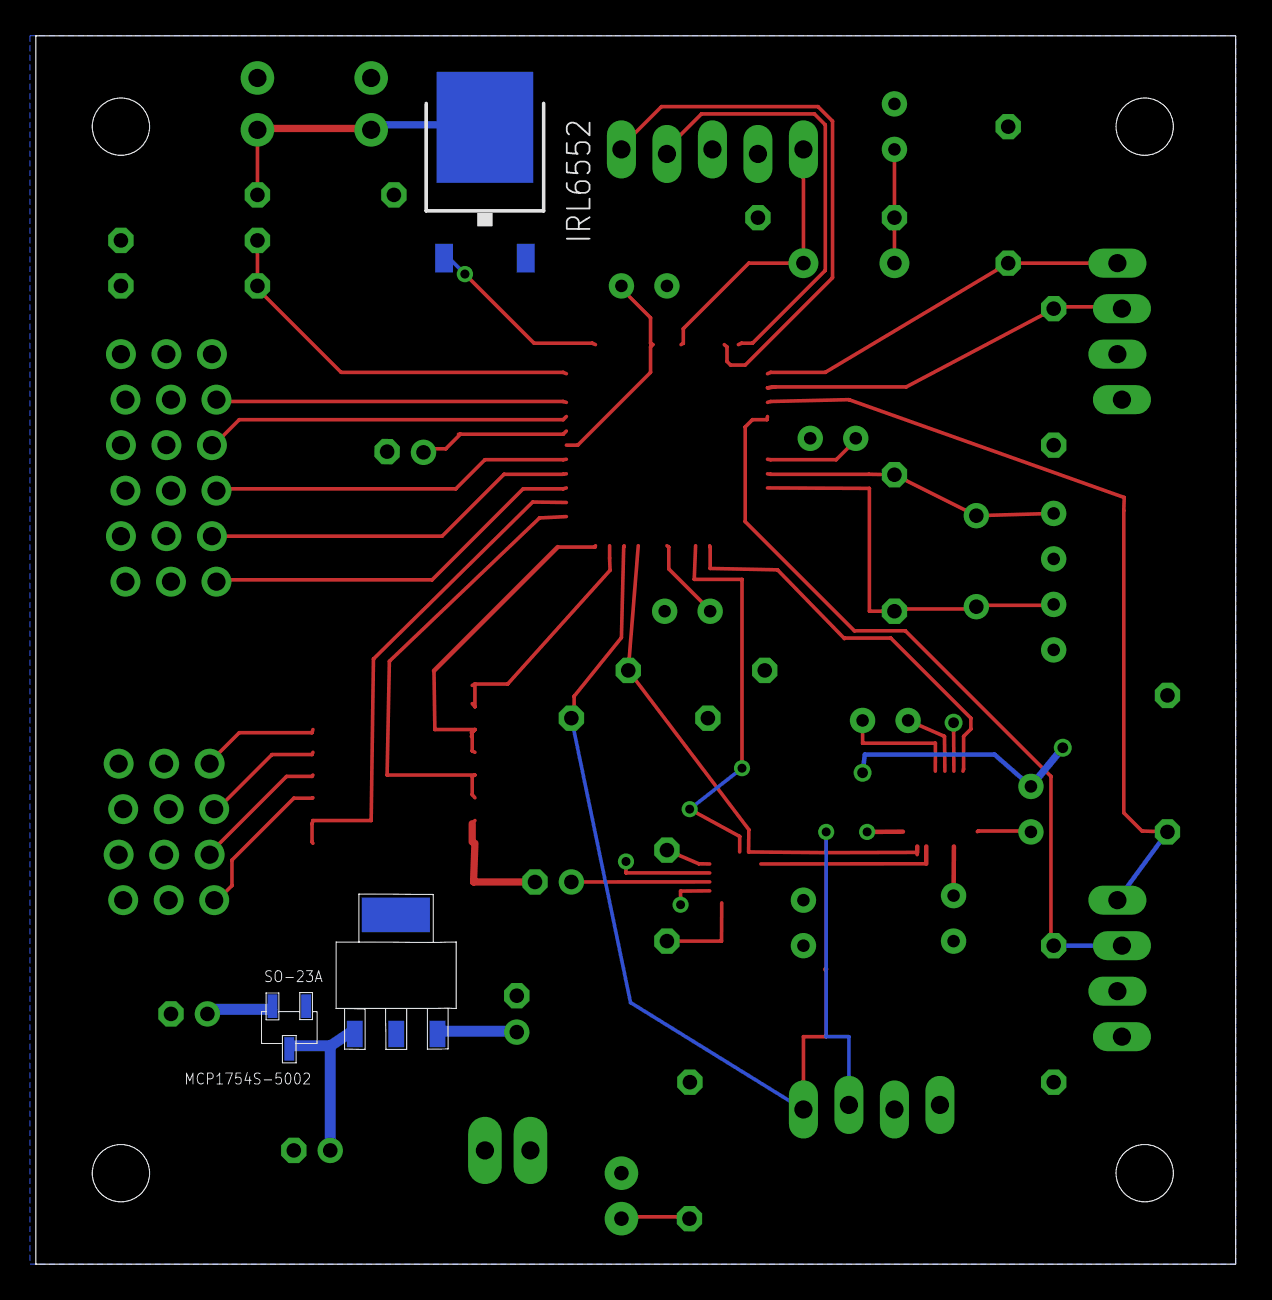
[picture p18: board Control Board.brd from below]

Board: 2 copper layers, 67.0 x 68.6 mm, 47 parts (3 on the bottom side), 41 nets.
