themathgeek13/custom-pic-quad/SD-Logger/SD-Logger-V2/Eagle/DataLoggerV2.brd

## EAGLE design SD-Logger/SD-Logger-V2/Eagle/DataLoggerV2.brd (2014-03-21)

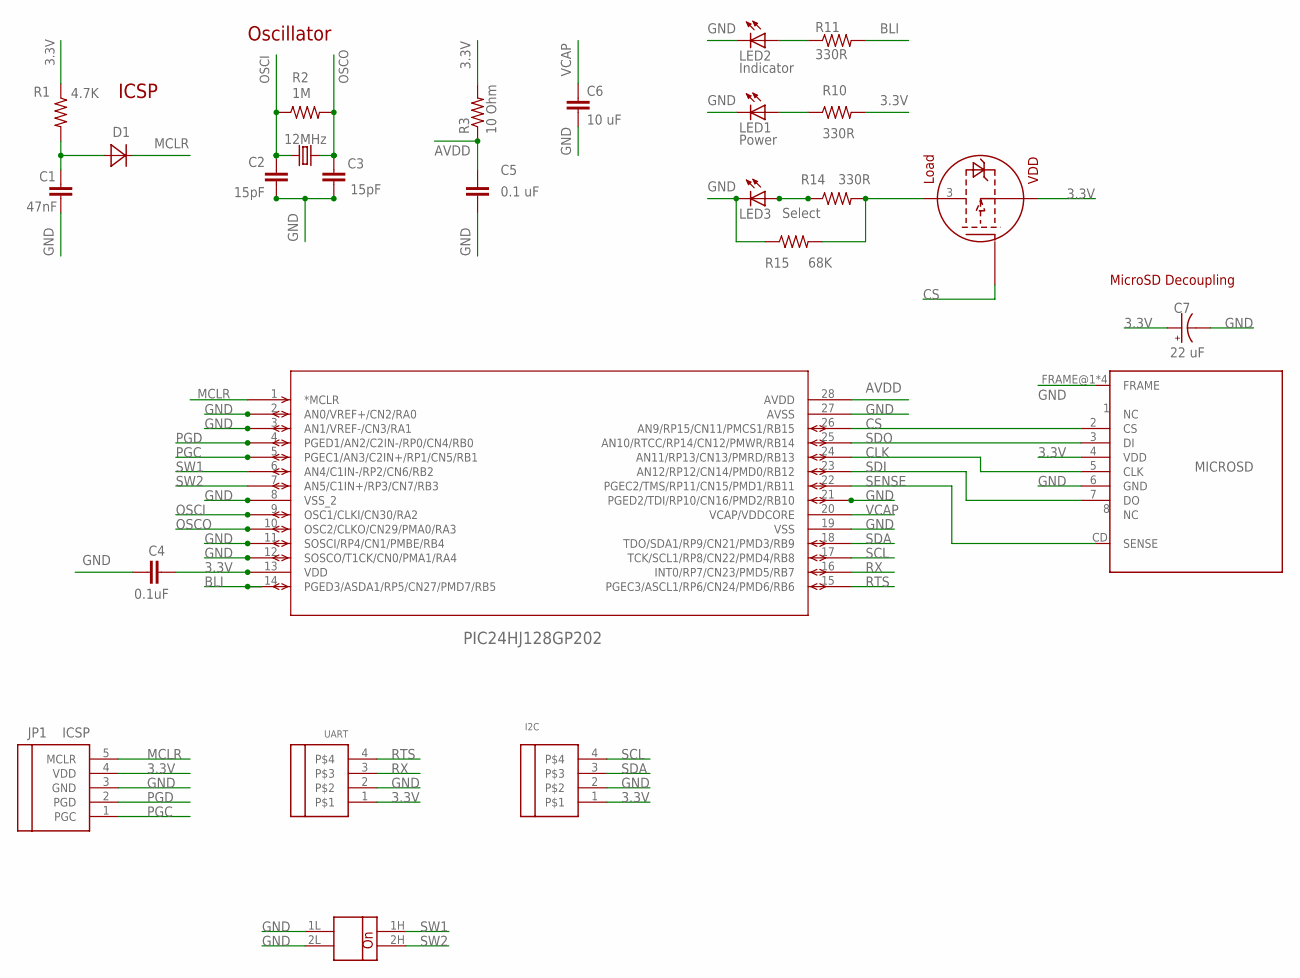
[picture p19: schematic DataLoggerV2.sch, sheet 1]

Parts:
C1: 47nF; 0805_INCH-HS-CAP
C2, C3: 15pF; 0805_INCH-HS-CAP
C4: 0.1uF; 0603_INCH-HS-CAP
C5: 0.1 uF; 0603_INCH-HS-CAP
C6: 10 uF; 1210_INCH-HS-CAP
C7: 22 uF; TANT-C-6032
D1: DIODE_1206; 1206_INCH-HS-DIODE
I2C: HEADER-04_JST-ZH_JST-ZH; 1X04-JST-ZH
JP1: ICSP; 1X05-JST-ZH
LED1: Power; 1206_INCH-HS-LED
LED2: Indicator; 1206_INCH-HS-LED
LED3: Select; 1206_INCH-HS-LED
P-FET: NTS2101P; SOT-323-0NSEMI
Q1: 12MHz; CRYSTAL-SMD-5.0X3.2
R1: 4.7K; 0805_INCH-HS
R2: 1M; 0805_INCH-HS
R3: 10 Ohm; 0805_INCH-HS
R10, R11, R14: 330R; 0805_INCH-HS
R15: 68K; 0805_INCH-HS
U$1: PIC24HJ128GP202; SOIC28-W_MC
U$2: MICROSD; MICROSD_V1
U$3: SWITCH-2_HALF-PITCH; DIP-2-HP
UART: HEADER-04_JST-ZH_JST-ZH; 1X04-JST-ZH

Connections:
3.3V: C4.1, C7.+, I2C.1, JP1.4 (VDD), P-FET.2 (S), R1.1, R3.2, R10.2, U$1.13 (VDD), U$2.4 (VDD), UART.1; also elsewhere on the board
AVDD: C5.1, R3.1, U$1.28 (AVDD)
BLI: R11.2, U$1.14 (PGED3/ASDA1/RP5/CN27/PMD7/RB5)
CLK: U$1.24 (AN11/RP13/CN13/PMRD/RB13), U$2.5 (CLK); also elsewhere on the board
CS: P-FET.1 (G), U$1.26 (AN9/RP15/CN11/PMCS1/RB15), U$2.2 (CS); also elsewhere on the board
GND: C1.2, C2.1, C3.1, C4.2, C5.2, C6.P$2 (2), C7.-, I2C.2, JP1.3 (GND), LED1.C, LED2.C, LED3.C, R15.1, U$1.2 (AN0/VREF+/CN2/RA0), U$1.3 (AN1/VREF-/CN3/RA1), U$1.8 (VSS_2), U$1.11 (SOSCI/RP4/CN1/PMBE/RB4), U$1.12 (SOSCO/T1CK/CN0/PMA1/RA4), U$1.19 (VSS), U$1.21 (PGED2/TDI/RP10/CN16/PMD2/RB10), U$1.27 (AVSS), U$2.6 (GND), U$2.FRAME@1 (FRAME), U$2.FRAME@2 (FRAME), U$2.FRAME@3 (FRAME), U$2.FRAME@4 (FRAME), U$3.1L, U$3.2L, UART.2; also elsewhere on the board
MCLR: D1.C, JP1.5 (MCLR), U$1.1 (*MCLR)
unnamed: C1.1, D1.A, R1.2
unnamed: LED3.A, R14.1
unnamed: LED1.A, R10.1
unnamed: LED2.A, R11.1
unnamed: P-FET.3 (D), R14.2, R15.2
OSCI: C2.2, Q1.P$2 (2), R2.1, U$1.9 (OSC1/CLKI/CN30/RA2)
OSCO: C3.2, Q1.P$1 (1), R2.2, U$1.10 (OSC2/CLKO/CN29/PMA0/RA3)
PGC: JP1.1 (PGC), U$1.5 (PGEC1/AN3/C2IN+/RP1/CN5/RB1)
PGD: JP1.2 (PGD), U$1.4 (PGED1/AN2/C2IN-/RP0/CN4/RB0)
RTS: U$1.15 (PGEC3/ASCL1/RP6/CN24/PMD6/RB6), UART.4; also elsewhere on the board
RX: U$1.16 (INT0/RP7/CN23/PMD5/RB7), UART.3; also elsewhere on the board
SCL: I2C.4, U$1.17 (TCK/SCL1/RP8/CN22/PMD4/RB8); also elsewhere on the board
SDA: I2C.3, U$1.18 (TDO/SDA1/RP9/CN21/PMD3/RB9); also elsewhere on the board
SDI: U$1.23 (AN12/RP12/CN14/PMD0/RB12), U$2.7 (DO); also elsewhere on the board
SDO: U$1.25 (AN10/RTCC/RP14/CN12/PMWR/RB14), U$2.3 (DI); also elsewhere on the board
SENSE: U$1.22 (PGEC2/TMS/RP11/CN15/PMD1/RB11), U$2.CD (SENSE)
SW1: U$1.6 (AN4/C1IN-/RP2/CN6/RB2), U$3.1H
SW2: U$1.7 (AN5/C1IN+/RP3/CN7/RB3), U$3.2H
VCAP: C6.P$1 (1), U$1.20 (VCAP/VDDCORE)

Notes on the sheet:
ICSP
Oscillator
MicroSD Decoupling

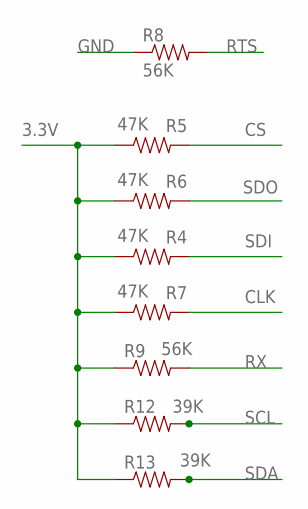
[picture p20: schematic DataLoggerV2.sch, sheet 2]

Parts:
R4, R5, R6, R7: 47K; 0805_INCH-HS
R8, R9: 56K; 0805_INCH-HS
R12, R13: 39K; 0805_INCH-HS

Connections:
3.3V: R4.1, R5.1, R6.1, R7.1, R9.1, R12.1, R13.1; also elsewhere on the board
CLK: R7.2; also elsewhere on the board
CS: R5.2; also elsewhere on the board
GND: R8.1; also elsewhere on the board
RTS: R8.2; also elsewhere on the board
RX: R9.2; also elsewhere on the board
SCL: R12.2; also elsewhere on the board
SDA: R13.2; also elsewhere on the board
SDI: R4.2; also elsewhere on the board
SDO: R6.2; also elsewhere on the board

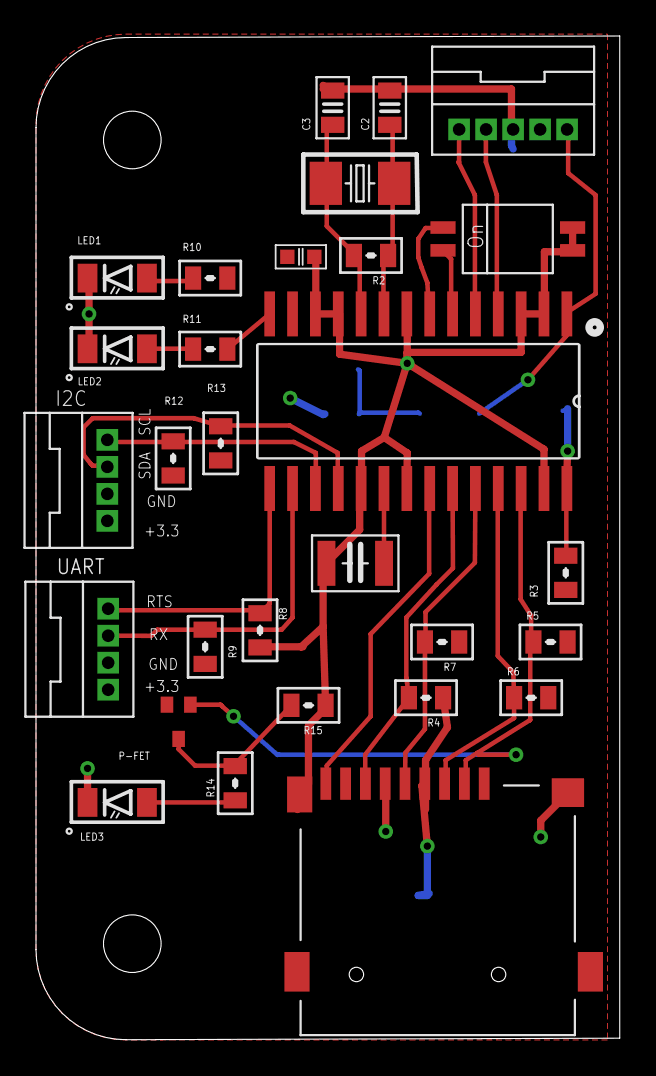
[picture p21: board DataLoggerV2.brd from above]

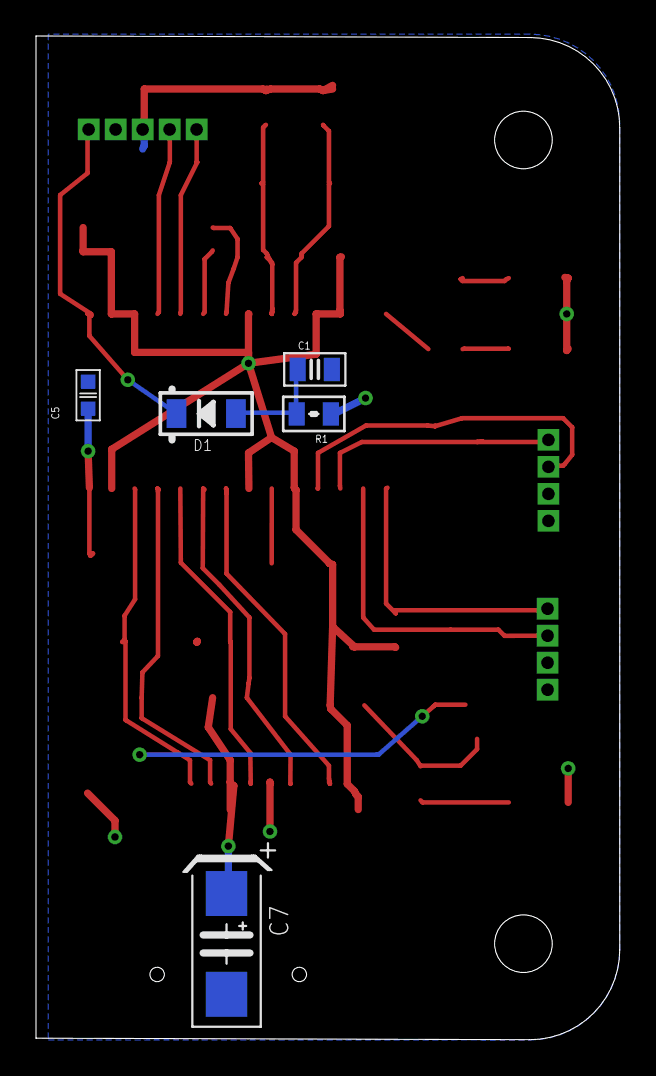
[picture p22: board DataLoggerV2.brd from below]

Board: 2 copper layers, 32.4 x 55.8 mm, 34 parts (5 on the bottom side), 26 nets.
