themathgeek13/custom-pic-quad/SD-Logger/SD-Logger-V1/Eagle/Data Logger.brd

## EAGLE design SD-Logger/SD-Logger-V1/Eagle/Data Logger.brd (2013-10-31, an earlier design)

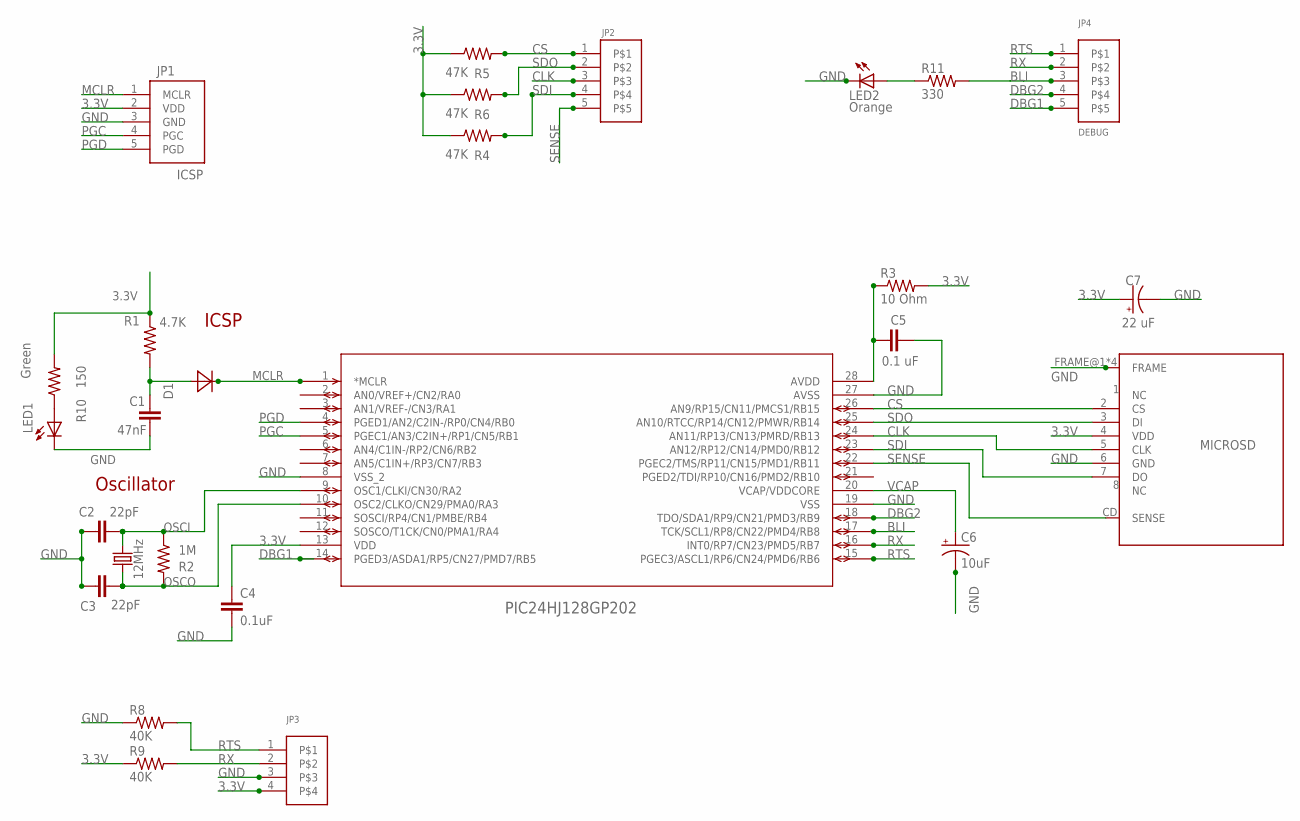
[picture p23: schematic Data Logger.sch]

Parts:
C1: 47nF; 0805_INCH-HS-CAP
C2, C3: 22pF; 0805_INCH-HS-CAP
C4: 0.1uF; 0805_INCH-HS-CAP
C5: 0.1 uF; 0805_INCH-HS-CAP
C6: 10uF; CAP-ELE-5MM
C7: 22 uF; TANT-C-6032
D1: DIODE_TTH; DO34-5
JP1: ICSP; 1X05-PRECISE
JP2: HEADER-05_MACHINED; 1X05_MACHINED
JP3: HEADER-04_PRECISE-NO-SILK; 1X04-PRECISE-NO-SILK
JP4: DEBUG; 1X05_MACHINED
LED1: Green; 1206_INCH-HS-LED
LED2: Orange; 1206_INCH-HS-LED
Q1: 12MHz; CRYSTAL-SMD-5.0X3.2
R1: 4.7K; 0805_INCH-HS
R2: 1M; 0805_INCH-HS
R3: 10 Ohm; 0805_INCH-HS
R4, R5, R6: 47K; 0805_INCH-HS
R8, R9: 40K; 0805_INCH-HS
R10: 150; 0805_INCH-HS
R11: 330; 0805_INCH-HS
U$1: PIC24HJ128GP202; SOIC28-W_MC
U$2: MICROSD; MICROSD_V1

Connections:
3.3V: C4.1, C7.+, JP1.2 (VDD), JP3.4, R1.1, R3.2, R4.1, R5.1, R6.1, R9.1, R10.2, U$1.13 (VDD), U$2.4 (VDD)
BLI: JP4.3, R11.2, U$1.17 (TCK/SCL1/RP8/CN22/PMD4/RB8)
CLK: JP2.3, U$1.24 (AN11/RP13/CN13/PMRD/RB13), U$2.5 (CLK)
CS: JP2.1, R5.2, U$1.26 (AN9/RP15/CN11/PMCS1/RB15), U$2.2 (CS)
DBG1: JP4.5, U$1.14 (PGED3/ASDA1/RP5/CN27/PMD7/RB5)
DBG2: JP4.4, U$1.18 (TDO/SDA1/RP9/CN21/PMD3/RB9)
GND: C1.2, C2.1, C3.1, C4.2, C5.2, C6.-, C7.-, JP1.3 (GND), JP3.3, LED1.C, LED2.C, R8.1, U$1.8 (VSS_2), U$1.19 (VSS), U$1.27 (AVSS), U$2.6 (GND), U$2.FRAME@1 (FRAME), U$2.FRAME@2 (FRAME), U$2.FRAME@3 (FRAME), U$2.FRAME@4 (FRAME)
MCLR: D1.C, JP1.1 (MCLR), U$1.1 (*MCLR)
unnamed: C1.1, D1.A, R1.2
unnamed: C5.1, R3.1, U$1.28 (AVDD)
unnamed: LED1.A, R10.1
unnamed: LED2.A, R11.1
OSCI: C2.2, Q1.P$2 (2), R2.1, U$1.9 (OSC1/CLKI/CN30/RA2)
OSCO: C3.2, Q1.P$1 (1), R2.2, U$1.10 (OSC2/CLKO/CN29/PMA0/RA3)
PGC: JP1.4 (PGC), U$1.5 (PGEC1/AN3/C2IN+/RP1/CN5/RB1)
PGD: JP1.5 (PGD), U$1.4 (PGED1/AN2/C2IN-/RP0/CN4/RB0)
RTS: JP3.1, JP4.1, R8.2, U$1.15 (PGEC3/ASCL1/RP6/CN24/PMD6/RB6)
RX: JP3.2, JP4.2, R9.2, U$1.16 (INT0/RP7/CN23/PMD5/RB7)
SDI: JP2.4, R4.2, U$1.23 (AN12/RP12/CN14/PMD0/RB12), U$2.7 (DO)
SDO: JP2.2, R6.2, U$1.25 (AN10/RTCC/RP14/CN12/PMWR/RB14), U$2.3 (DI)
SENSE: JP2.5, U$1.22 (PGEC2/TMS/RP11/CN15/PMD1/RB11), U$2.CD (SENSE)
VCAP: C6.+, U$1.20 (VCAP/VDDCORE)

Notes on the sheet:
ICSP
Oscillator

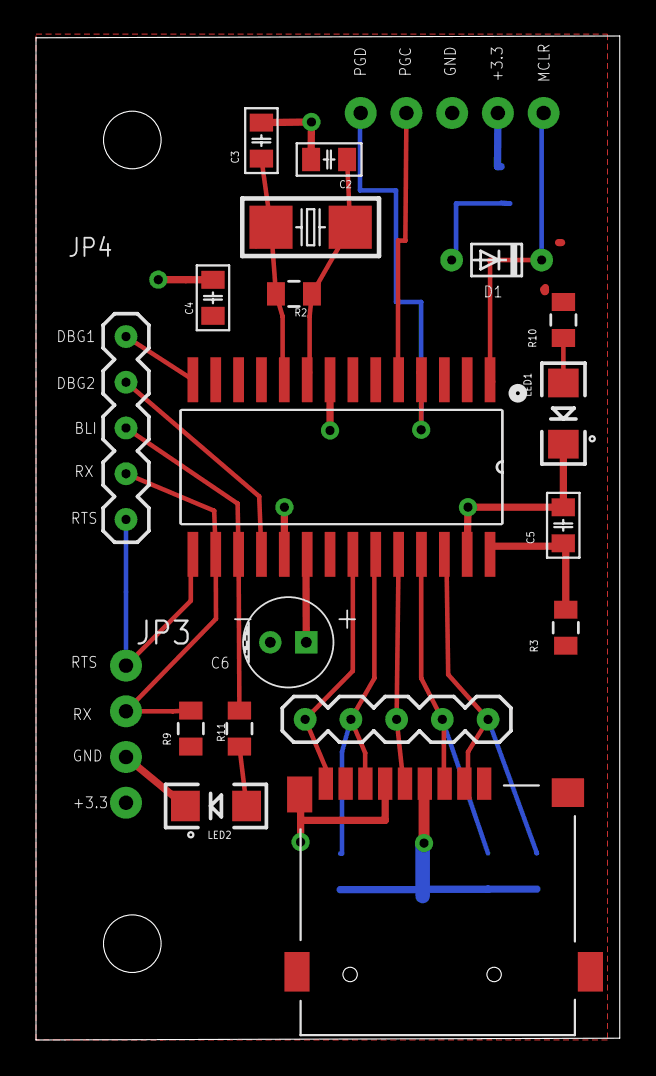
[picture p24: board Data Logger.brd from above]

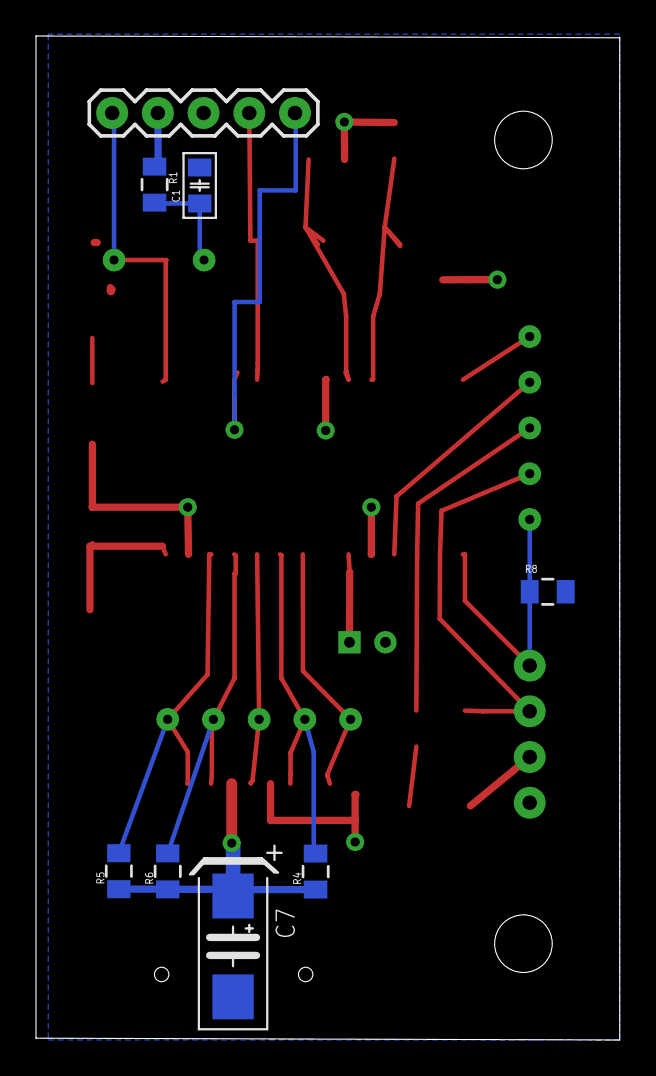
[picture p25: board Data Logger.brd from below]

Board: 2 copper layers, 32.4 x 55.8 mm, 27 parts (8 on the bottom side), 22 nets.
