themathgeek13/custom-pic-quad/Quad-V3/00-COMMON/HMCSPI/HMCSPI_Init.c

#include "HMCSPI\HMCSPI_Local.h"

//==================================================================
HMC_RC	HMC_Init(byte IL, byte ODR, byte Gain, byte DLPF)
	//--------------------------------------------------------------
	// Parameters ODR, Gain, and DLPF are passed through to
	// HMCSPI_Reset(...) function and explained there.
	//--------------------------------------------------------------
	{
	if (_HMC_Init)
	  return HMC_OK;		// Avoid duplicate initialization
	//---------------------------------------------------------
	_HMC_Init = 1;	// Mark that module is initialized
	//---------------------------------------------------------
	// This module uses timer; hopefully Timer is already
	// initialized, but...
	//---------------------------------------------------------
	TMRInitDefault();
	//---------------------------------------------------------
	if (IL < 1) IL = 1;
	if (IL > 7) IL = 7;
	_HMC_IL	= IL;
	//---------------------------------------------------------
	// Prepare SPI Module for configuration
	//---------------------------------------------------------
	SPISTAT		= 0;	// Disable SPI for configuration
	//---------------------------------------------------------
	// Please NOTE that the Init program disables all PERIPHERAL
	// MODULES using PMDx registers. To continue configuring and
	// later enabling Input Capture module we need to enable
	// module in PMDx
	//---------------------------------------------------------
	SPI_MD		= 0;	// Enable SPI module
	Nop();				// Skip one cycle to let modules enable
	//---------------------------------------------------------
	// Configure INTx Module
	//---------------------------------------------------------
	HMC_IE		= 0;			// Disable INTx interrupt
	HMC_IF		= 0; 			// Clear INTx interrupt flag
	HMC_EP		= 0;			// Interrupt on POSITIVE edge
	HMC_IP		= _HMC_IL;		// Set INTx interrupt priority
	//---------------------------------------------------------
	// Configure relevant pins of the MCU
	//---------------------------------------------------------
	_HMCInitPinMap ();
	//---------------------------------------------------------
	// Configure SPI Module parameters
	//---------------------------------------------------------
	CKP		= 1;		// Clock - Idle High
	MSTEN	= 1;		// MCU is the master
	SPRE	= 0b111;	// Secondary PRE = 1:1
	PPRE	= 0b01;		// Primary	 PRE = 16:1 for SPI clock
						// speed of 4 MHz assuming MCU runs at
						// 64 MHz
	SPIBEN	= 0b1;		// Enable "enhanced" mode (FIFO)
	//---------------------------------------------------------
	// Configure SPI interrupts
	//---------------------------------------------------------
	SPI_IE	= 0;			// Disable interrupts
	SPI_IF	= 0;			// Reset interrupt request (if any)
	SPI_IP	= _HMC_IL;		// Set interrupt priority
	// Set SPI Buffer interrupt mode (valid only in FIFO Mode)
	SISEL	= 0b101;		// Interrupt when the last bit is
							// shifted out of SPIxSR and the
							// transmit is complete
	//---------------------------------------------------------
	// Start SPI Module
	//---------------------------------------------------------
	SPIEN	= 1;
	//---------------------------------------------------------
	// NOTE: Interrupts for SPI module are still disabled; they
	//		 will be enabled in INTx interrupt routine before
	//		 initiation of I/O operation
	//---------------------------------------------------------
	return HMC_ReSet(ODR, Gain, DLPF);
	}
//==================================================================
