themathgeek13/custom-pic-quad/Quad-V3/00-COMMON/I2C/I2C_SyncRead.c

#include "I2C\I2C_Local.h"
#include "TMR\TMR.h"

//************************************************************
// Synchronous READ - I2C API (visible externally) component
//************************************************************
uint	I2CSyncRead(	uint	I2Cx,
						byte 	DevAddr, 
						byte	Register,
						byte* 	Buffer,
						uint  	BufLen )
	{
	if (!_I2C_Init)		return I2CRC_NRDY;
	//=========================================================
	// Obtain references to proper Control Blocks and registers
	//---------------------------------------------------------
	_I2C_CB*		pCB;
	if ( NULL == (pCB = I2CpCB(I2Cx)) )		return I2CRC_NOTA;
	//---------------------------------------------------------
	I2C_CONBITS*	pCON	= I2CpCON(pCB);
	I2C_STATBITS*	pSTAT	= I2CpSTAT(pCB);
	//=========================================================
	// Validate run-time conditions
	//---------------------------------------------------------
	uint	RC;
	BYTE	CPU_IPL;
	uint	RetryCount	= 0;

	//---------------------------------------------------------
	// Enter I2C (and related modules) CRITICAL SECTION
	//---------------------------------------------------------
Retry:
	RC	= I2CRC_OK;
	//------------------------------------
	SET_AND_SAVE_CPU_IPL(CPU_IPL, _I2C_IL);
		{
		if (I2CRC_OK == (RC=I2CGetStatus(pCB, pCON, pSTAT)))
			//---------------------------------------------------------
			// Set Flag indicating Synchronous operation is in progress
			//---------------------------------------------------------
			pCB->_I2C_SBSY	= 1;	// Should be cleared at exit
		}  
	//---------------------------------------------------------
	// Leave I2C CRITICAL SECTION
	//---------------------------------------------------------
  	RESTORE_CPU_IPL(CPU_IPL);
	//=========================================================
	switch (RC)	
		{
		case	I2CRC_OK:
			break;		// Run-time conditions are OK
		//-------------------------------------------
		case	I2CRC_ABSY:
		case	I2CRC_SBSY:
		case	I2CRC_BUSY:
			// Situation could be helped by delay/retry
			if (RetryCount < I2C_BUSYRetry)
				{
				TMRDelayTicks(1);	// Small delay ~125 usec
				RetryCount++;
				goto Retry;					// Attempt retry
				}
			else;		// Fall through to "default"
		//-------------------------------------------
		default:
			return RC;	// Run-time conditions are not met
		}
	//=========================================================

	//---------------------------------------------------------
	// Event sequence to accomplish simple READ from the target
	// slave device in the MASTER mode:
	//	1. Assert a Start condition on SDAx and SCLx.
	//	2. Send the I2C device address byte to the slave with a
	//	   read indication ("1" in the LSB of address)
	//	3. Wait for and verify an Acknowledge from the slave.
	//	4. Assert receiving state (RCEN = 1).
	//	5. Receive byte and send ACK to the slave.
	//	6. Repeat steps 4 and 5 for every byte in a message, 
	//	   except the last - after receiving last byte send NACK.
	//	7. Generate a Stop condition on SDAx and SCLx.
	//---------------------------------------------------------
	// Prepare READ and WRITE forms of device address
	byte	i2cAddrW	= DevAddr & 0xFE;	// Set WRITE cond.
	byte	i2cAddrR	= DevAddr | 0x01;	// Set READ cond.
	//---------------------------------------------------------
	RC			= I2CRC_OK;
	//---------------------------------------------------------
	I2CStart(pCB);		// Signal START on SDA and SCL pins
	//---------------------------------------------------------
	// Send Device WRITE address
	//---------------------------------------------------------
	RC = I2CMasterWriteByte(pCB, i2cAddrW);
	if (RC != I2CRC_OK)	goto Finally;
	//---------------------------------------------------------
	// Send Register address (as data))
	//---------------------------------------------------------
	RC = I2CMasterWriteByte(pCB, Register);
	if (RC != I2CRC_OK)	goto Finally;
	//---------------------------------------------------------
	I2CReStart(pCB);	// Signal Repeated-START on SDA and SCL pins
	//---------------------------------------------------------
	// Send Device READ address
	//---------------------------------------------------------
	RC = I2CMasterWriteByte(pCB, i2cAddrR);
	if (RC != I2CRC_OK)	goto Finally;
	//---------------------------------------------------------
	// Receive data
	//---------------------------------------------------------
	pSTAT->I2COV = 0;	// Clear receive OVERFLOW bit, if any
	//---------------------------------------------------------
	uint	BufPos;
	uint	BufCnt	= BufLen;
	//---------------------------------------------------------
	for (BufPos = 0; BufPos < BufLen; BufPos++)
		{
		BufCnt--;	// Used as a FLAG (BufCnt=0) to indicate last byte
		//---------------------------------------------------------
		RC = I2CMasterReadByte(pCB, Buffer, BufCnt);
		if (RC != I2CRC_OK)
			break;			// Error...
		Buffer++;
		}
	//---------------------------------------------------------
Finally:
	I2CStop(pCB);			// Signal STOP on SDA and SCL pins
	//---------------------------------------------------------
	pCB->_I2C_SBSY	= 0;	// Clear SYNC flag
	return RC;				// Return last Error Code...
	}
//************************************************************
