themathgeek13/custom-pic-quad/Quad-V3/00-COMMON/HMCSPI/HMCSPI_Local.c

#include "HMCSPI\HMCSPI_Local.h"

//==================================================================
uint				_HMC_Init	= 0;	// Not initialized
//------------------------------------------------------------------
byte				_HMC_IL		= 4; 	// SPI default interrupt
											// level

//==================================================================
// HMC Sensor data normalization values
//==================================================================
// HMC Sensitivity in mGs/LSB, adjusted in the ReSet(...) routine
// NOTE: Earth magnetic field is around 0.25-0.65 Gs
float				_HMC_Gain	= 0.0;
//------------------------------------------------------------------
// MAG Hard Iron correction vector
Vector				_HMC_HardIron	=  {0.0, 0.0, 0.0};
// MAG Soft Iron correction matrix
Vector				_HMC_SoftIron_X	=  {1.0, 0.0, 0.0};
Vector				_HMC_SoftIron_Y	=  {0.0, 1.0, 0.0};
Vector				_HMC_SoftIron_Z	=  {0.0, 0.0, 1.0};
//==================================================================



//==================================================================
// Asynchronous read support
//==================================================================
volatile	uint	_HMC_Async	= 0;	// Asynchronous read mode flag
//------------------------------------------------------------------
volatile	uint	_HMC_Ready	= 0;	// Flag indicating whether asynch-
										// ronous read data is ready
//------------------------------------------------------------------
_HMCRawData			_HMC_Sample;		// Asynchronous sample...
//==================================================================
