themathgeek13/custom-pic-quad/Quad-V3/00-COMMON/SDL/SDL_ISR.c

#include "SDL\SDL_Local.h"


//************************************************************
void __attribute__((__interrupt__,__no_auto_psv__)) SDLInterrupt(void)
	{
	if (_SDL_Buf_Len > 0)
		{
		while ( (_SDL_Buf_Len > 0) && (0 == UTXBF) )
			{
			// We still have data to transfer...
			UTXREG = _SDL_Buf[_SDL_Buf_Index];
			//----------------------------------
			_SDL_Buf_Index++;	// Adjust index to next character
			_SDL_Buf_Len--;	// Adjust counter of bytes in buffer
			}
		}
	else
		{
		//----------------------------------
		// As we generate UART TX interrupts only when buffer
		// is empty, when we enter interrupt routine we have 4 
		// slots in the buffer...
		// Send "STOP" delimiter (double _SDL_Stop)
		//----------------------------------
		UTXREG = _SDL_Stop;
		asm ("nop"); // We need at least one cycle delay between writes to U1TXREG ...
		UTXREG = _SDL_Stop;
		//----------------------------------
		// Nothing more to transmit...
		UTXIE			= 0;	// Disable UART TX interrupt
		_SDL_Ready		= 1;	// Indicate readiness for next
								// message.
		}
	//-------------------------------------------------
	UTXIF		= 0; 		// Clear UART TX interrupt flag
	//-------------------------------------------------
	return;
	}
//************************************************************
