themathgeek13/custom-pic-quad/(commit log)

2013-09-28 Code base using Gyro rates to calculate PID differential term
2013-09-28 Minor efficiency update - IMUInit stops magnetometer after calculating base Azimuth
2013-10-05 Restored (after crash!) version of Firmware that uses dP/dT to calculate state derivatives for PID; includes changes required to use the 2.4 GHz receiver (instead of the original 72Mhz one.
    [main.c]
2013-10-16 Intermediate update - added module (MXB) to work with MaxBotix sonar, changed throttle logic to take into account battery discharge during flight, working on Matrix3D module to consolidate matrix ope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
2013-10-16 UART module updated to use Profile header to consolidate changes required when the pin assignment changes.
2013-10-17 Intermediate update - added project "12-Matrix3D" to test matrix operations; updated calculation of Angular Velocity (just to show the data for now) to use partial (no Yaw) DCM; updated DCM, IMU, and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
2013-10-31 Updated TMR routines to provide new functions to set and check for Alarms; increased resolution of real time calculation from 1 msec to 125 usec - now Delay and Alarm functions more precise. Added Ea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
    [Data Logger.brd, Data Logger.sch]
2013-11-03 Release 1.1. Added functionality to fly in "+" and "X" configurations, added option for "Course Lock" a-la DJI Phantom, increased precision of TMRDelay function and added TMRSetAlarm and TMRWaitAlarm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
    [main.c]
2013-11-05 Added Eagle files
    [Control Board.brd, Control Board.sch]
2013-11-26 Adding MPL3115 Barometric Sensor
2013-11-28 Removed MaxBotix from the project - data is very unstable; added MPL3115A2 Barometric Altimeter by Freescale. Modified HMCMAG to use Input Capture (IC2) module instead of INT2 and added HW Profile to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
    [I2C_Profile.h, main.c]
2014-05-19 A fully functional Quad control firmware with MPL3115A barometric altimeter and US-20 ultrasonic sensor. Unfortunately precision is not sufficient for automatic landing without proper fusion of all a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
    [Data Logger.brd, Data Logger.sch]
2014-06-29 Prior to major rework of I2C module to allow for up to 2 buses
    [I2C.h, I2C_Async.c, I2C_ISR.c, I2C_Init.c, I2C_Local.c, I2C_Local.h, I2C_Profile.h, I2C_Sync.c]
2014-07-06 Reworked I2C and MPU APIs
    [I2C.h, I2C_Async.c, I2C_ISR.c, I2C_Init.c, I2C_Local.c, I2C_Local.h, I2C_Profile.h, I2C_Sync.c]
2014-07-06 Checkpoint prior to another review of I2C subscription model
2014-07-13 I2C Library updated to provide to provide fully asynchronous operation with multiple subscribers.
2014-07-13 Some renaming in Quad-V2 subtree
    [Control Board.brd, Control Board.sch]
2014-07-21 Added Eagle folder
    [ControlBoardV3-4L.brd, ControlBoardV3-4L.sch]
2014-07-31 Increased RC roll/pitch input to +/-35 degree; reduced level of IIR smoothing of RC input to IIR(2).
